ziolman/robothand1234/rysunki_obrazy_ilustracje/4_modul_pomiarowy_pola_magnetycznego.jpg

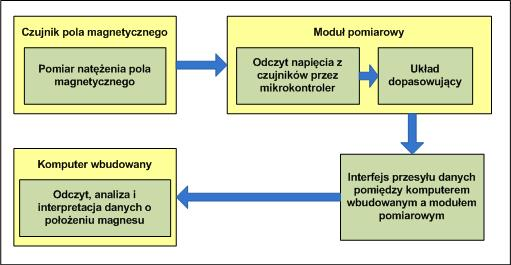
rysunki_obrazy_ilustracje/4_modul_pomiarowy_pola_magnetycznego.jpg
