ziolman/robothand1234/rysunki_obrazy_ilustracje/rys.jpg

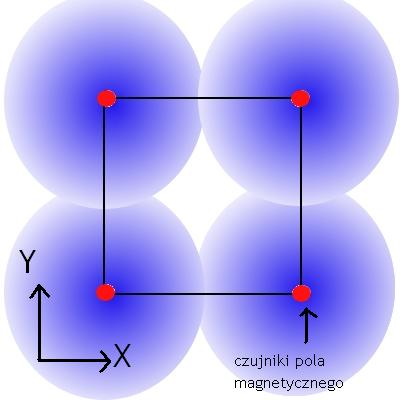
rysunki_obrazy_ilustracje/rys.jpg
