ziolman/robothand1234/projects/stepper_motor_translator_driver/stepper_motor_translator_driver (PCB - Schematic and PCB Check Report).txt

Schematic and PCB Check Report
------------------------------

Report File    : C:\Biblioteki\Robothand\robothand1234\projects\stepper_motor_translator_driver\stepper_motor_translator_driver (PCB - Schematic and PCB Check Report).txt
Report Written : Tuesday, December 25, 2012
Project Path   : C:\Biblioteki\Robothand\robothand1234\projects\stepper_motor_translator_driver\stepper_motor_translator_driver.prj
Design Path    : C:\Biblioteki\Robothand\robothand1234\projects\stepper_motor_translator_driver\stepper_motor_translator_driver.pcb
Design Title   : 
Created        : 2012-11-28 19:48:20
Last Saved     : 2012-12-17 07:27:35
Editing Time   : 3419 min
Units          : mm (precision 1)

Checking integrity of Schematic "C:\Biblioteki\Robothand\robothand1234\projects\stepper_motor_translator_driver\stepper_motor_translator_driver.sch" with PCB "C:\Biblioteki\Robothand\robothand1234\projects\stepper_motor_translator_driver\stepper_motor_translator_driver.pcb"
==================================================================================================================================================================================================================================================================================

Ignoring instance H1 ("MOUNT-HOLE3.0") as it has no schematic information.
Ignoring instance H2 ("MOUNT-HOLE3.0") as it has no schematic information.
Ignoring instance H3 ("MOUNT-HOLE3.0") as it has no schematic information.
Ignoring instance H4 ("MOUNT-HOLE3.0") as it has no schematic information.

Change value "R" on component reference "R7" to "10 Ohm".

Change value "R" on component reference "R8" to "10 Ohm".

End Of Report.
