ziolman/robothand1234/projects/uart_rs485/uart_rs485 (PCB - Pour Copper Report).txt

Pour Copper Report
------------------

Report File    : C:\Biblioteki\Robothand\robothand1234\projects\uart_rs485\uart_rs485 (PCB - Pour Copper Report).txt
Report Written : Sunday, December 23, 2012
Design Path    : C:\Biblioteki\Robothand\robothand1234\projects\uart_rs485\uart_rs485.pcb
Design Title   : 
Created        : 2012-12-22 23:36:58
Last Saved     : 2012-12-23 00:08:53
Editing Time   : 38 min
Units          : mil (precision 1)

End Of Report.
