ziolman/robothand1234/projects/differential_amplifiers_sensors_multi/differential_amplifiers_sensors (PCB - Pour Copper Report).txt

Pour Copper Report
------------------

Report File    : C:\Biblioteki\Robothand\robothand1234\projects\differential_amplifiers_sensors_multi\differential_amplifiers_sensors (PCB - Pour Copper Report).txt
Report Written : Tuesday, December 11, 2012
Project Path   : C:\Biblioteki\Robothand\robothand1234\projects\differential_amplifiers_sensors_multi\differential_amplifiers_sensors.prj
Design Path    : C:\Biblioteki\Robothand\robothand1234\projects\differential_amplifiers_sensors_multi\differential_amplifiers_sensors.pcb
Design Title   : 
Created        : 2012-12-11 06:53:57
Last Saved     : 2012-12-11 20:35:18
Editing Time   : 807 min
Units          : mil (precision 1)

End Of Report.
