ziolman/robothand1234/projects/fan controller/fan_controller (PCB - Pour Copper Report).txt

Pour Copper Report
------------------

Report File    : C:\Biblioteki\Robothand\robothand1234\projects\fan controller\fan_controller (PCB - Pour Copper Report).txt
Report Written : Friday, December 14, 2012
Design Path    : C:\Biblioteki\Robothand\robothand1234\projects\fan controller\fan_controller.pcb
Design Title   : 
Created        : 2012-12-14 09:00:22
Last Saved     : 2012-12-14 12:18:20
Editing Time   : 191 min
Units          : mil (precision 0)

End Of Report.
