ziolman/robothand1234/projects/magnetic_sensors_circuit/magnetic_sensors_circuit (PCB - Pour Copper Report).txt

Pour Copper Report
------------------

Report File    : C:\Biblioteki\Robothand\robothand1234\projects\magnetic_sensors_circuit\magnetic_sensors_circuit (PCB - Pour Copper Report).txt
Report Written : Friday, December 14, 2012
Project Path   : C:\Biblioteki\Robothand\robothand1234\projects\magnetic_sensors_circuit\magnetic_sensors_circuit.prj
Design Path    : C:\Biblioteki\Robothand\robothand1234\projects\magnetic_sensors_circuit\magnetic_sensors_circuit.pcb
Design Title   : 
Created        : 2012-12-14 14:24:42
Last Saved     : 2012-12-14 18:47:26
Editing Time   : 264 min
Units          : mil (precision 0)

End Of Report.
