ziolman/robothand1234/Praca magisterska BZ.docx

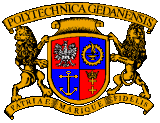
[picture p3: figure]
GODLO_C
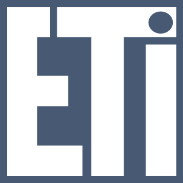
[picture p4: figure]
logo_eti

| Politechnika Gdańska WYDZIAŁ ELEKTRONIKI TELEKOMUNIKACJI I INFORMATYKI

Katedra: Metrologii i Optoelektroniki

Imię i nazwisko dyplomanta: Bartosz Ziółek

Nr albumu: 113592

Forma i poziom studiów: stacjonarne II stopnia

Kierunek studiów: elektronika i telekomunikacja

Praca dyplomowa

Temat pracy: Wbudowany system pomiarowy dedykowany dla ramienia ręki

Opiekun pracy: dr hab. inż. Wojciech Toczek

Zakres pracy:

1. Przegląd literatury na temat konstrukcji rąk robotów oraz systemów ich sterowania
2. Projekt ręki robota
3. Projekt systemu pomiarowego
4. Projekt systemu sterowania ręką robota
5. Wykonanie, uruchomienie oraz przetestowanie prototypu urządzenia

Gdańsk, 2012 rok

OŚWIADCZENIE

Oświadczam, że niniejszą pracę dyplomową wykonałem samodzielnie. Wszystkie informacje umieszczone w pracy uzyskane ze źródeł pisanych oraz informacje ustne pochodzące od innych osób zostały udokumentowane w wykazie literatury odpowiednimi odnośnikami.

podpis dyplomanta

Spis treści

# 1. Wstęp

Metody pomiarowe i diagnostyczne pełnią ważną funkcję w robotyce. Są szczególnie istotne w przypadku trudnych pomiarów, jak na przykład pomiary dokładności odtwarzania trajektorii w przestrzeni roboczej przy dużych prędkościach przemieszczania kiści robota.

W ramach pracy magisterskiej oraz rozwijania własnej pasji związanej z automatyką i robotyką zrealizowano wbudowany system pomiarowy dedykowany dla ręki robota humanoidalnego. Został przedstawiony zarys aktualnego stanu wiedzy na temat wielopalczastych manipulatorów zwanych, jako ręce robotów lub zręczne dłonie robotów, na tle dostępnych i opublikowanych rozwiązań konstrukcyjnych rąk robotów. Zaproponowano eksperymentalną konstrukcję oraz innowacyjny system i instalację sterowania humanoidalną kończyną górną robota. Podjęto próbę replikacji możliwości oraz złożoności ludzkiej ręki oraz jego kinematyczną oraz dynamiczną strukturę, gdzie najbardziej istotnym elementem jest system pomiarowy zastosowany w prototypie. Przeanalizowano niektóre ważne prace prowadzone na całym świecie w ostatnich trzech dekadach, dokonano przeglądu dostępnych aktuatorów, sensorów oraz technologii sterowania ramionami robotów antropomorficznych. Przedstawiono niespotykane wcześniej podejście w projektowaniu systemów pomiarowych dedykowanych dla ramion robotów, proponując eksperymentalne podejście sterowania manipulatorem.

W ramach pracy magisterskiej wykonano następujące zadania:

- dokonano przeglądu literatury dotyczącej konstrukcji robotów przemysłowych oraz humanoidalnych i systemów ich sterowania następnie sformułowano wymagania techniczne oraz technologiczne dla projektowanego urządzenia,
- zaprojektowano konstrukcję ramienia robota,
- wybrano komputer wbudowany,
- wybrano czujniki oraz układy dopasowujące,
- zaprojektowano schematy ideowe sterowników silników krokowych, układów dopasowujących oraz wzmacniających sygnały sensorów robota
- zaprojektowano oraz wykonano płytkę drukowaną prototypu sterownika silnika krokowego
- zaprojektowano i wykonano oprogramowanie komputera wbudowanego oraz mikroprocesorów
- wykonano prototyp ramienia robota humanoidalnego
- uruchomiono i przebadano działający prototyp
- poświęcono uwagę zagadnieniom sterowania z uwzględnieniem siły w układach ze sprzężeniem zwrotnym

Zaprojektowany system pomiarowy dedykowany jest dla manipulatora antropomorficznego.

# 2. Przegląd literatury oraz dostępnych rozwiązań konstrukcyjnych rąk robotów

## 2.1 Wybrane konstrukcje dłoni robotów humanoidalnych – struktury kinematyczne, systemy pomiarowe oraz napędowe

Dłoń ludzka jest jednym z najbardziej skomplikowanych, po mózgu, organem ludzkiego ciała. Jest przedmiotem studiów i badań nie tylko w medycynie, ale również w dziedzinie inżynierii.

### 2.1.1 Dłoń Utah/MIT

Dłoń Utah/MIT (ang. The Utah/MIT Hand) została opracowania przez Centrum Inżynierii Projektowej na Uniwersytecie w Utah oraz w Laboratorium Sztucznej Inteligencji w Instytucie Technologicznym w Massachusetts. Konstrukcja efektora końcowego robota miała funkcjonować jako narzędzie badawcze ogólnego przeznaczenia do badań sprawności podobnych rozwiązań konstrukcyjnych. Pierwotnie miała przypominać ludzką dłoń, ostatecznie przypominała quasi-antropomorficzną dłoń z trzema palcami oraz jednym kciukiem. Powodem, dla którego konstrukcja miała przypominać ludzką dłoń były, w pierwszej kolejności, badania systemu pomiarowego oraz czujników stosowanych wcześniej w podobnych konstrukcjach, po drugie, umożliwienie badaczom porównania oraz odwzorowywania operacji ręki ludzkiej za pomocną mechanicznej ręki robota. Strukturę mechaniczną danej konstrukcji przedstawia rysunek poniżej.

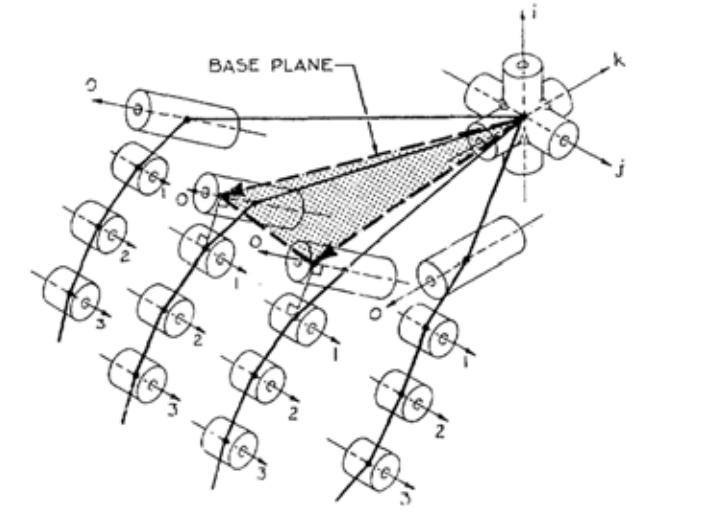
[picture p5: figure]

Rys. 2.1 Konfiguracja dłoni Utah/MIT (wersja trzecia projektu, połączenia 0 są równoległe do podstawy) [1]

Wykorzystano ścięgno-pasowy mechanizm przy każdym z siłowników z 16 stopni swobody. W tego typu mechanizmach jeden koniec ścięgna jest połączony z siłownikiem pneumatycznym, natomiast drugi jest zamocowany na zawiasie, który znajduje się na przemieszczanym segmencie palca. W celu zapewnienia prawidłowego działania, dwa pierwsze połączenia każdego palca oddzielono w taki sposób, że mogą ścięgna być kierowane prawidłowo, co ma istotne znaczenie w systemie pomiarowym dedykowanym dla danego rozwiązania.

Czujniki wewnętrzne dłoni umieszczone są na każdym połączniu w celu pomiaru odchylenia kątowego. System czujników oparty jest na efekcie Halla. Czujniki działające na danej zasadzie umieszczone są w bliższym ogniwie a dwa magnesy samarto-kobaltowe, działające w konfiguracji dipola, są dołączone do dalszego ogniwa. Pozostałe czujniki umieszczone są w każdym z 32 modułów wykrywania napięcia ścięgien zlokalizowanych w nadgarstku. Wykorzystywane zostały również czujniki tensometryczne do pomiarów siły działającej na każdą z belek podtrzymujących napinacze ścięgien, w postaci lin.

Do każdego z dwóch przegubów zamocowano dwa ścięgna, co spowodowało, iż liczba siłowników wymaganych do ich poruszania podwoiła liczbę złączy palców. W wersji trzeciej projektu dłoni Utah/MIT wykorzystano podwójne siłowniki składające się z dwóch ciśnieniowych zaworów sterujących, dwóch cylindrycznych siłowników pneumatycznych. Cylindry siłowników, tłoki siłowników oraz pozostałe mechanizmy napędowe ważyły łącznie 20 kg.

### 2.1.2 Konstrukcja robonauty

### 2.1.3 Dłoń belgradzka/USC

### 2.1.4 Dłoń cień

### 2.1.5 Czarne palce

# 3. Projekt manipulatora oraz systemu pomiarowego, głowne założenia projektowe

## 3.1 Założenia projektowe, podstawowe wymagania dotyczące ręki robota i dedykowanego systemu pomiarowego

# 4. Mechanika ręki robota a system pomiarowy i sterowania robota

## 4.1 Struktura manipulatora

## 4.2 Kinematyka manipulatora

## 4.3 Dynamika oraz statyka zaprojektowanego manipulatora

## 4.4 Konstrukcja chwytaka

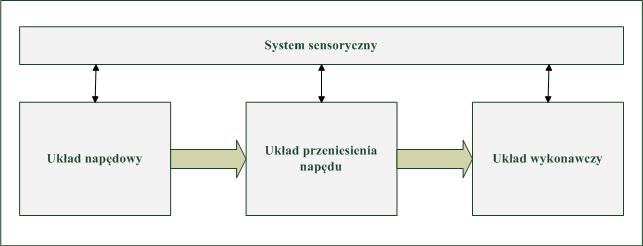
[picture p6: figure]

Rys. 4.1 Schemat blokowy chwytaka [2, p. 231]

# 5. Czujniki i układy sensoryczne robota dedykowane dla projektowanego wbudowanego systemu pomiarowego

Układy sensoryczne w robotyce są ważnymi elementami konstrukcji robotów. W celu prawidłowego funkcjonowania zaprojektowanej ręki robota wymagane było zaprojektowanie wielu układów pomiarowych służących do wprowadzania informacji o cechach mechanicznych, fizykochemicznych środowiska zewnętrznego, o orientacji oraz współrzędnych manipulatora i jego poszczególnych elementach składowych jak i stanie zewnętrznym środowiska otaczającego robota. Uzyskiwane dane wykorzystywane są do sterowania manipulatorem z zastosowaniem sprzężeń zwrotnych, sprzężonych z komputerem wbudowanym robota.

Stworzono klasyfikację układów sensorycznych na potrzeby danej pracy na podstawie [3, p. 198] oraz [2, pp. 261-291], co zobrazowano na rysunku Rys. 5.1. Kolorem zielonym zaznaczono rodzaje czujników wykorzystywanych w projekcie.

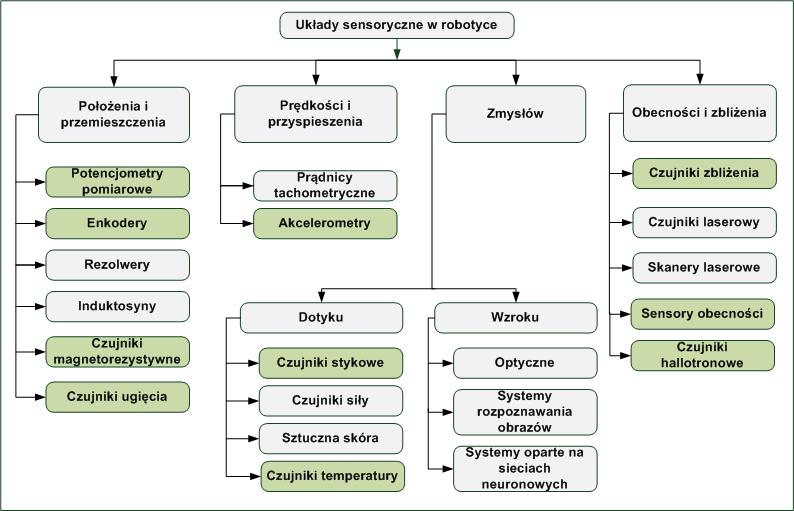
[picture p7: figure]

Rys. 5.1 Klasyfikacja układów sensorycznych analizowanych oraz stosowanych w danym projekcie

## 5.1 Układy pomiarowe położenia i przemieszczenia

### 5.1.1 Moduł sensoryczny położenia i przemieszczenia z czujnikami magnetorezystywnymi – badanie czujników, prototyp modułu pomiarowego

Do pomiaru położenia końców poszczególnych segmentów robota w przestrzeni wykorzystano czujniki magnetorezystywne pola magnetycznego. Stworzono eksperymentalny moduł pomiarowy celem sprawdzenia dokładności pomiarów oraz ich przydatności w określaniu położenia w przestrzeni trójwymiarowej manipulatora w danym projekcie.


Rys. 5.2 Schemat blokowy modułu pomiarowego pola magnetycznego

Na rysunku Rys. 5.2 przedstawiony został schemat blokowy zbudowanego prototypu modułu pomiarowego pola magnetycznego. Moduł czujników pola magnetycznego złożony jest z odpowiednio rozmieszczonych czujników natężenia pola magnetycznego (wykorzystywano czujniki KMZ10C oraz SS49), przewodów doprowadzających sygnały z czujników do modułu pomiarowego (w celu zwiększenia niezawodności pomiarów oraz dokładności podjęto próbę ekranowanie danych przewodów, jednak nie stwierdzono żadnej poprawy niezawodności). Głównym elementem widocznego na schemacie modułu pomiarowego jest mikrokontroler ATMEGA32. Moduł składa się również z układów dopasowujących oraz wzmacniających sygnały z czujników. W celu przesyłu danych do komputera wykorzystywany jest interfejs RS-232. Aplikacja napisana w języku C uruchamiana jest na komputerze wbudowanym wyposażonym w złącze RS-232 lub jeśli jest do dyspozycji konwerter RS-232 – USB – w port USB. Wykorzystując dany program odczytywane są pomiary ze wszystkich sensorów na podstawie których następuje interpretacja położenia magnesu w przestrzeni dwuwymiarowej bądź trójwymiarowej, w zależności od zastosowanego modelu matematycznego. Aplikacja umożliwia także kalibrację układu czujników, uzyskiwanych pomiarów. Dzięki funkcji auto-kalibracji urządzenie nie wymaga przeznaczania sporych wysiłków na poprawne skalibrowanie – oszczędność czasu.

Powodzenie próby dokonania poprawnych i dokładnych pomiarów zależało przede wszystkim od doboru odpowiednich czujników natężenia pola magnetycznego. Znaczną część czasu przeznaczoną na projektowanie urządzenia przeznaczono na rozeznanie i wybór właściwych czujników magnetorezystywnych: KMZ10C. Są to dość tanie elementy, których wykorzystanie pozwala na zbudowanie magnetycznego miernika położenia. Zastosowanie dokładniejszych, droższych czujników (np. KMZ51) pozwoliłoby na uzyskanie większej dokładności oraz pozwoliłoby na zmniejszenie liczby czujników wymaganych do poprawnego określania położenia obiektu w przestrzeni. Nie otrzymano oczekiwanych rezultatów przy wykorzystaniu danego modułu, jednak ze względu na podjętą próbę zastosowania czujników magnetorezystywnych w konstrukcji ręki robota (o danej metodzie pomiarowej stosowanej przy robotach humanoidalnych projektant nie znalazł żadnych informacji w dostępnej literaturze oraz Internecie) opisano w danej pracy przeprowadzone eksperymenty oraz wyciągnięto odpowiednie wnioski.

Zastosowany w module eksperymentalnym sensor to czujnik pola magnetycznego o dużej czułości wykorzystujący zjawisko megnetorezystancji. Stosowany jest do pomiaru natężenia pola magnetycznego. Jego działanie opiera się na zmianie rezystancji elektrycznej materiałów, z których został wykonany, poddanych działaniu pola magnetycznego. Struktura wewnętrzna czujnika zawiera pełny mostek magnetorezystywny. Czujniki tego rodzaju charakteryzują się dużą czułością. Schemat czujnika KMZ10C, jego struktura wewnętrzna oraz rozkład wyprowadzeń został przedstawiony poniżej na rysunku Rys. 5.3 oraz Rys. 5.4.Ze względu na specyfikę oraz konstrukcję płytki PCB modułu pomiarowego, możliwość ustawiania własnej konfiguracji urządzenia, konieczna jest znajomość wyprowadzeń czujnika, jego orientacji w przestrzeni względem położenia magnesu.

Rys. 5.3 Schemat czujnika KMZ10 – rozkład wyprowadzeń – struktura czujnika [4]

Rys. 5.4 Schemat czujnika KMZ10C – rozkład wyprowadzeń [4]

Rys. 5.5 Charakterystyka wyjściowa czujnika KMZ10 (Hy-natężenie pola magnetycznego, V0-napięcie wyjściowe czujnika) [4]

Zobrazowane spektrum, zakres wykrywania pola magnetycznego przez dany czujnik, wykorzystywane w projekcie, ukazano na Rys. 5.6, natomiast na rysunku Rys. 5.5 przedstawiono charakterystykę wyjściową czujnika KMZ10C. W idealnych warunkach czujnik charakteryzuje się liniową charakterystyką wyjściową – co jest dużą zaleta. Wykorzystując dany sensor można dokonać pomiaru w dwóch płaszczyznach Hx oraz Hy W projekcie wykorzystano pomiar pola magnetycznego w płaszczyźnie y (zgodnie z zamieszczonym powyżej rysunkiem), gdyż czujnik w takim położeniu, w odniesieniu do mierzonego pola magnetycznego, charakteryzuje się największą czułością oraz zakresem pomiarowym. Zakres pomiarowy, zgodnie z dokumentacją czujnika (sprawdzono doświadczalnie): -7,5 kA/m .. +7,5 kA/m, natomiast czułość to: 1,5 (mV/V)/(kA/m). Maksymalne napięcie zasilania czujnika wynosi 10 V.

Poprzez zastosowanie odpowiedniego układu wzmacniacza, możliwe stało się wykrywanie/mierzenie natężenia pola magnetycznego w odległości ok. 30-25 cm od źródła danego pola. Zaprojektowany układ (schemat) wzmacniacza dedykowany dla danego czujnika przedstawiono na Rys. 5.7. Poprzez zastosowanie rezystorów o większej wartości rezystancji możliwe jest zwiększenie wzmocnienia danego układu.

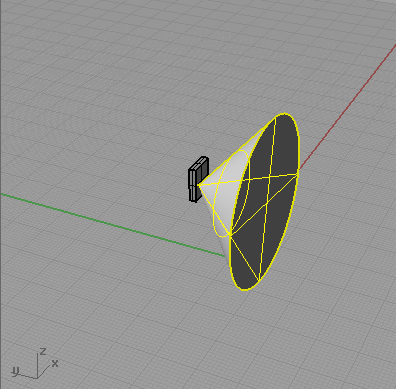
[picture p8: figure]

Rys. 5.6 Spektrum, zakres wykrywania pola magnetycznego przez czujnik KMZ10C - wizualizacja dokonana przez projektanta w programie Blender

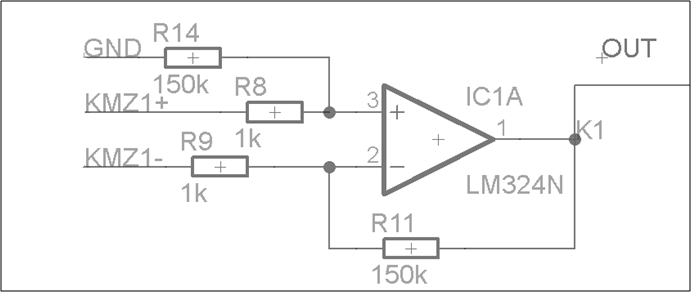
[picture p9: figure]

Rys. 5.7 Układ wzmacniacza sygnału z czujnika KMZ10C

Właściwości czujników KMZ10C umożliwiają stosowanie ich w pomiarach prądu i pola magnetycznego, czujnikach zbliżeniowych, układach pomiaru położenia.

Wyjścia sygnałowe czujników zbadano za pomocą oscyloskopu oraz multimetru, podczas przemieszczania magnesu względem czujnika na wykreślonej wcześniej, odpowiednio wyskalowanej tarczy (Rys. 5.8). Przy pomiarach nie można było wykluczyć działania pola magnetycznego Ziemi (zauważalne były zmiana sygnału wyjściowego przy przemieszczaniu czujnika KMZ10C względem powierzchni ziemi – przy odpowiednio dużym wzmocnieniu sygnału wyjściowego). Z wykorzystaniem czujnika KMZ10C wykrywano zmiany natężenia pola magnetycznego (po wzmocnieniu sygnału) ze znacznie większej odległości w porównaniu z wykorzystaniem innych dostępnych dla projektanta czujnikami hallotronowymi.

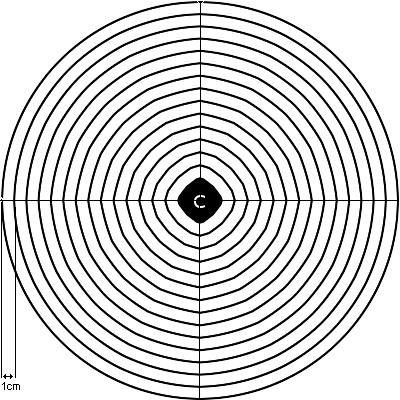
[picture p10: figure]

Rys. 5.8 Schemat szablonu pomiarowego dla czujników pola magnetycznego (C - miejsce położenia czujnika)

Ważne było, jaki magnes został wykorzystywany do przeprowadzania testów wybranych czujników. Używając różnych magnesów (materiał z jakich zostały wykonane), o różnych wymiarach oraz różnym stopniu namagnesowania otrzymano inne wyniki przy pomiarze napięć wyjściowych (sygnałów wyjściowych) z czujników. W danym projekcie modułu wykorzystywano magnes ferrytowy.

Przebadano zmiany napięcia wyjściowego wybranego czujnika magnetorezystywnego w funkcji odległości magnesu od czujnika. Wyniki przedstawiono w tabeli 5.1.

Tabela 5.1 Wyniki pomiarów zmian sygnału wyjściowego czujnika KMZ10C przy zmianie odległości położenia magnesu ferrytowego od czujnika

odległość magnesu od czujnika [cm] | wartość napięcia – wyjście czujnika [mV] (sygnał wzmocniony)
16 | 26
15 | 28
14 | 30
13 | 32
12 | 35
11 | 40
10 | 46
9 | 56
8 | 69
7 | 89
6 | 123
5 | 174
4 | 272
3 | 475
2 | 698

Na podstawie tych danych wyznaczono charakterystykę wyjściową czujnika KMZ10C w funkcji odległości od danego magnesu w kształcie prostopadłościanu (Rys. 5.9 Charakterystyka wyjściowa dla czujnika KMZ10C w funkcji odległości od magnesu ferrytowego w kształcie prostopadłościanu).

Rys. 5.9 Charakterystyka wyjściowa dla czujnika KMZ10C w funkcji odległości od magnesu ferrytowego w kształcie prostopadłościanu

Na podstawie wykresu zamieszczonego powyżej widać, iż rozkład pola magnetycznego w przestrzeni nie jest liniowy. Natężenie pola magnetycznego wzrasta znacznie, jeśli magnes jest zbliżany do czujnika. Bazując na tych danych wyznaczono (z wykorzystaniem programu Aproksymacja) zależność napięcia wyjściowego czujnika od odległości położenia magnesu od sensora:

| V_(out) =2600,1r^(-1,708) | 5.1

ogólnie:

| Vout = γr⁻¹,⁷ | 5.2

Widoczne jest podobieństwo danej zależności do [5]:

F_m =m_m H=m_m^2 /4πμ_0 r^2

gdzie:

Fm – siła magnetyczna

mm – „masa magnetyczna”

H – natężenie pola magnetycznego

μ0 – przenikalność magnetyczna próżni

r – odległość od źródła pola magnetycznego

W danym przypadku:

γ = m_m^2 /4πμ_0

jest stałą, zależną od rodzaju magnesu (materiał, wymiary, kształt), wyznaczaną doświadczalnie. Poprawne działanie aplikacji interpretującej położenie magnesu w przestrzeni było uzależnione od poprawnego wyznaczenia tej zależności dla wybranego magnesu, który był wykorzystywany. Rozbieżność w wykładnikach potęg zmiennej r we wzorach (4.1) oraz (4.3) wynika m.in. z nieliniowości, zniekształceń wnoszonych przez układy wzmacniaczy.

W projekcie modułu głównym przeznaczeniem mikrokontrolera jest odpowiednie próbkowanie kanałów z wyjść czujników analogowych (po odpowiednim wcześniejszym wzmocnieniu), przekształcenie ich na sygnał cyfrowy (przetworniki A/C), a następnie przesłanie do komputera wbudowanego za pomocą interfejsu RS-232. Do tego celu napisano odpowiednie oprogramowanie. Kod źródłowy został opisany w dalszej części danej pracy.

## 5.2 Układy sensoryczne zbliżenia i obecności

### 5.2.1 Układ pomiarowy z czujnikami hallotronowymi

W projekcie ręki robota wykorzystano czujniki hallotronowe, które pełnią rolę czujników zarówno obecności jak i zbliżenia. Czujniki hallotronowe dzieli się na przełączniki oraz czujniki liniowe [4, pp. 63-68]. Wykorzystano przełączniki, które posiadają wbudowany komparator ze zdefiniowanymi odpowiednio punktami przełączania oraz cyfrowym wyjściem, które zostało podłączone do systemu logicznego. W zależności od wartości i kierunku pola magnetycznego, wywołującego zadziałanie układu pomiarowego czujnika, przełączniki Halla są dzielone na kilka typów:

- blokujące (ang. latching sensors)
- jednobiegunowe (ang. unipolar sensors)
- dwubiegunowe (ang. bipolar sensors)

Wykorzystano dwa ostatnie typy czujników. Przełączniki jednobiegunowe nie wymagają zmian kierunku pola magnetycznego – polaryzacji, lecz jedynie jego wartości. Na ogół tego typu czujniki wymagają pola magnetycznego o polaryzacji dodatniej, skierowanej w stronę oznakowanej krawędzi czujnika. Taki czujnik nie reaguje na zmiany pola magnetycznego o polaryzacji odwrotnej (ujemnej).

Przełączniki dwubiegunowe są zbliżone w działaniu do przełączników blokujących. Charakterystyczne dla tych czujników jest, że sygnał wyjściowy z przetwornika nie zmienia się, jeżeli wartość natężenia pola magnetycznego dąży do zera (nie zawsze jednak w przypadku tych czujników jest spełniona zasada stałości sygnału wyjściowego, gdy pole magnetyczne). W celu zmiany stanu wyjścia należy przyłożyć do płytki Halla (zawartej w obudowie czujnika) pole magnetyczne o polaryzacji odwrotnej do działającej uprzednio. Jako czujnik unipolarny wybrano CS3144E. Są to czujniki, które posiadają wbudowany komparator ze zdefiniowanymi odpowiednio punktami przełączania oraz cyfrowym wyjściem, które zostało podłączone do systemu logicznego. Schemat funkcjonalny czujnika CS3144E pokazany jest na Rys. 5.2.

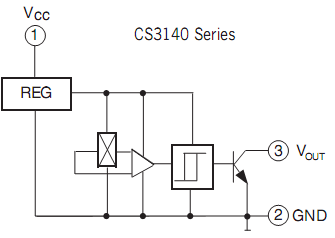
[picture p11: figure]

Rys. 5.10 Blok funkcjonalny czujnika hallotronowego serii CS3140 [5]

Maksymalne napięcie wejściowe i wyjściowe czujnika to 28 V, co odpowiada założeniom postawionym przez projektanta, opisanych w Rozdziale 3.1. Rozkład wyprowadzeń, charakterystyki zawarte są w dokumentacji czujnika w Załączniku X. Drugim czujnikiem jest czujnik bipolarny Halla AH175. Zakres napięć pracy czujnika to 3,5 V – 20 V, zarówno na wejściu jak i wyjściu układu półprzewodnikowego. Na Rys. 5.3 przedstawiono blok funkcjonalny wraz z wyprowadzeniami czujnika

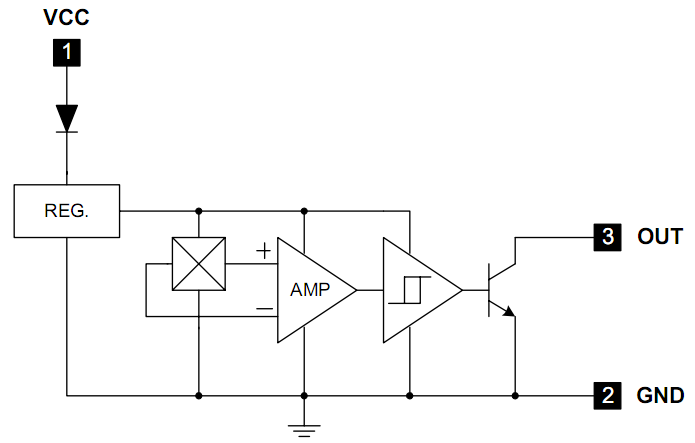
[picture p12: figure]

Rys. 5.11 Diagram blokowy czujnika AH175 [6]

W projekcie przewidziano również możliwość podłączenia liniowych czujników Halla. Generują one sygnał analogowy napięciowy proporcjonalny do indukcji magnetycznej działającej na płytkę Halla. Ten typ czujników stosowany jest m.in. do pomiaru kąta rozwarcia pomiędzy ramieniem a przedramieniem, położenia poszczególnych przegubów, stawów względem obudowy robota, kąta obrotu przegubu, może zostać również zastosowany do pomiaru natężeń prądów. Przykładem czujnika tego typu jest czujnik CS3503.

Każdy z czujników hallotronowych jest wzmacniany. Dokonywane jest to za pośrednictwem wzmacniacza różnicowego na bazie układu TL074. Napięcie wyjściowe poddawane jest regulacji z zakresu 2 V – 22 V. Schemat ideowy opisywanego układu jest przedstawiony na Rys. 5.4.

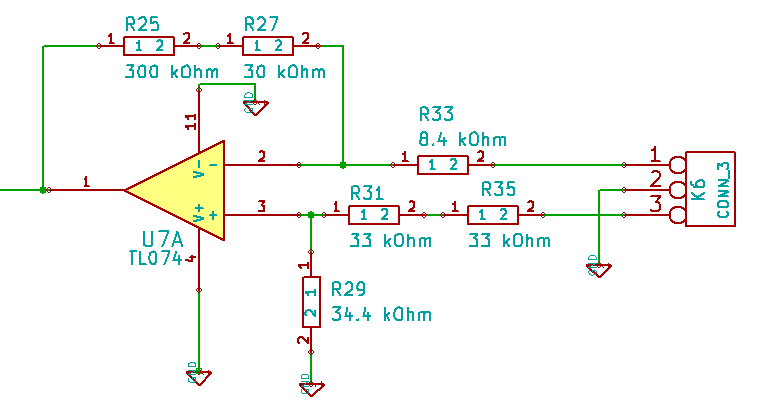
[picture p13: figure]

Rys. 5.12 Schemat ideowy układu wzmacniacza sygnału z czujnika Halla bipolarnego oraz unipolarnego

### 5.2.2 Wzmacniacz czujnika optycznego

Przewidziano możliwość dołączenia czujników fotoelektrycznych (optycznych). Są to diody kierunkowe oraz diody na podczerwień. Spełniają rolę markerów w celu określenia początkowych punktów pracy robota. Element nadawczy (w przypadku toru na podczerwień) stanowi dioda nadawcza CQYP16, fotodetektorem jest dioda odbiorcza BPW84. W układzie elektronicznego przełącznika świetlnego wykorzystano fototranzystor BPY22.

Układ wzmacniacza czujnika optycznego składa się ze wzmacniacza OP07CR, który pracuje w konfiguracji komparatora. Porównywany jest poziom napięcia pomiędzy wejściem odwracającym a nieodwracającym. Na wyjściu uzyskuje się wysoki albo niski sygnał, w zależności od napięcia zasilającego VCOM wzmacniacza. Napięcie na wejściu nieodwracającym jest ustalane przy pomocy potencjometru RV4 (Rys. 5.5). Kiedy fotodioda podłączona pod wejścia K13 (anoda – 2, katoda – 3) nie jest oświetlona, prąd płynący przez dany element elektroniczny nie płynie. Powoduje to wzrost napięcia na pinie 2 wzmacniacza, na wyjściu otrzymuje się niski poziom napięcia. Sytuacja jest odwrotna w momencie, w którym fotodioda zostaje oświetlona.

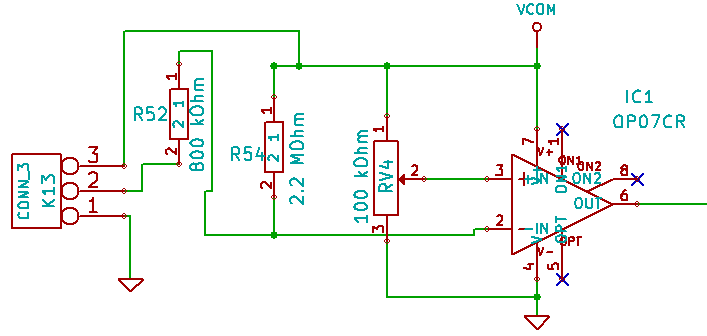
[picture p14: figure]

Rys. 5.13 Schemat ideowy układu przetwarzania sygnału czujnika optycznego

Rolę fotodiody może pełnić fotodioda kierunkowa, albo zastosowana przez konstruktora dioda IR BPW84. Jako diodę nadawczą zastosowano CQYP16 działającą również w zakresie podczerwieni. Podłączana jest również do złącza K13 do wejścia 1 oraz 3 (należy zwracać uwagę na prawidłowe połączenie elementu, polaryzację). Rezystor R52 pełni funkcję zabezpieczającą diody. W urządzeniu znajduje się dziesięć takich podukładów, istnieje możliwość podłączenia dziesięciu czujników optycznych (działających na takich samych zasadach, co przedstawione powyżej), w zależności od zaistniałych potrzeb.

# 6. Sterowanie oraz planowanie zadań robota

# 7. Podsumowanie, uwagi i wnioski końcowe

Wadą zaprojektowanej konstrukcji ramienia robota jest zastosowanie nieodpowiednich materiałów. Konstrukcja jest za ciężka - rozwój inżynierii materiałowej umożliwia obecnie stosowanie lekkich kompozytów do budowy robotów. Ma to również swoje zalety, ponieważ wykorzystywanie materiałów kompozytowych w budowie robotów prowadzi do zwiększenia prędkości, ale równolegle wywołuje efekt dynamicznej podatności, które należy uwzględnić w procesie sterowania. Ze względu na ograniczony czas przeznaczony na budowę ramienia nie stosowano podczas wykonania prototypu w stopniu odpowiednim metod symulacji komputerowych w zakresie projektowania robotów.

## 7.1 Dalsza wizja rozwoju projektu

W celu ukończenia projektu należy w dalszych etapach prac nad ręką robota:

- poprawić algorytm modelowania przestrzeni w aplikacji systemu wbudowanego opartego na komputerze typu embedded Beagle Board
- zaprojektować i wykonać poprawioną płytkę PCB układu sensorycznego położenia i przemieszczenia czujników magnetorezystywnych

# Bibliografia

[1] | S. C. Jacobsen, E. K. Iversen, D. F. Knutti, R. T. Johnson i K. B. Biggers, „Design of the Utah/M.I.T. Dextrous Hand,” w Proc. IEEE International Conference on Robotics and Automation, 1986.
[2] | Praca zbiorowa pod redakcją A. Moreckiego i J. Knapczyka, Podstawy robotyki - Teoria i elementy manipulatorów oraz robotów, III red., Warszawa: WNT, 1999.
[3] | J. Honczarenko, Roboty przemysłowe, Warszawa: WNT, 2004.
[4] | A. Gajek i Z. Juda, Czujniki, Mechatronika samochodowa, Warszawa: WKiŁ, 2008.
[5] | „Czujnik hallotronowy CS3144,” [Online]. Available: http://www.testequipmentdatasheets.com/index_cards/F/FW_Bell/CS3140.pdf. [Data uzyskania dostępu: 01 09 2012].
[6] | „Czujnik hallotronowy AH175,” [Online]. Available: http://www.chipcatalog.com/Anachip/AH175.htm.
[7] | J. W. Soto Martell i G. Gini, „Robotic Hands: Design Review and Proposal of New Design Process,” w World Academy of Science, Engineering and Technology 26, 2007.
