ziolman/robothand1234/projects/A3977_stepper_driver_second/A3977_stepper_driver.bmp

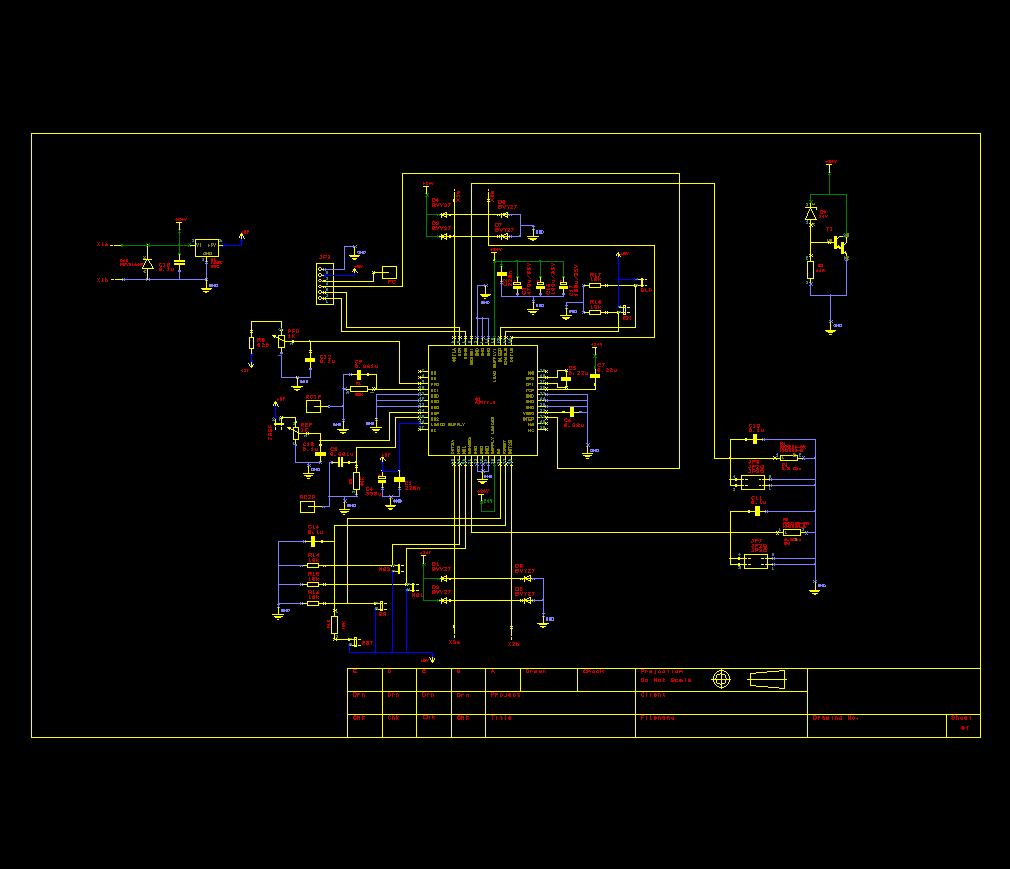
projects/A3977_stepper_driver_second/A3977_stepper_driver.bmp
