ziolman/robothand1234/rysunki_obrazy_ilustracje/5_schemat_blokowy_robota_reka.png

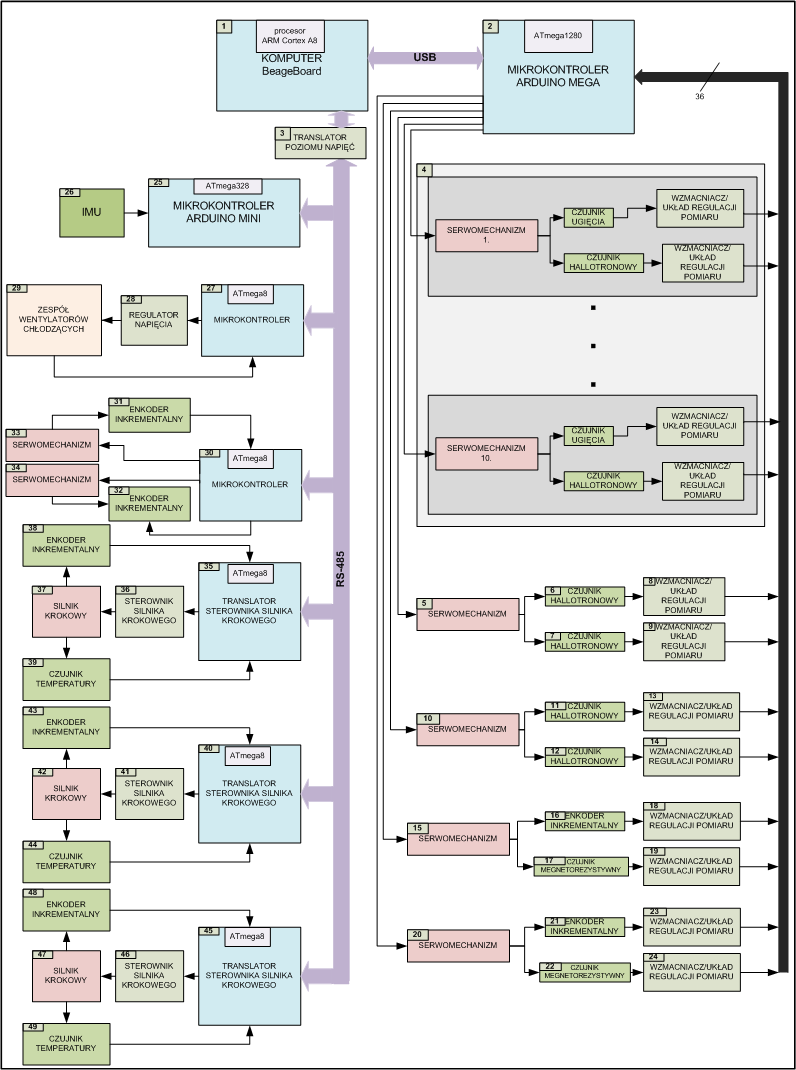
rysunki_obrazy_ilustracje/5_schemat_blokowy_robota_reka.png
