ziolman/robothand1234/rysunki_obrazy_ilustracje/9_interfejs_komunikacyjny_u_pomiarowy.png

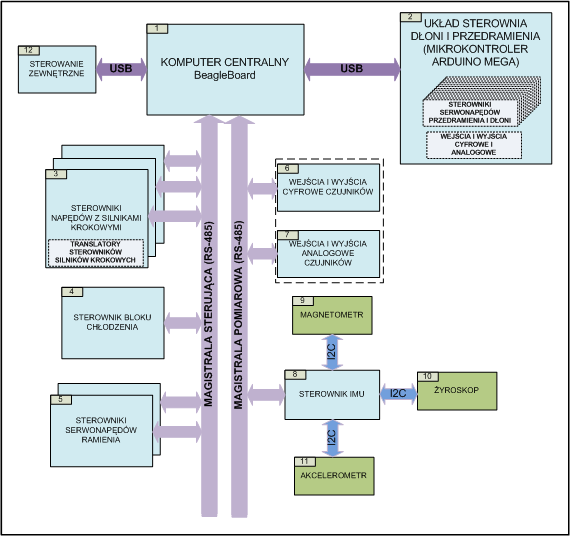
rysunki_obrazy_ilustracje/9_interfejs_komunikacyjny_u_pomiarowy.png
