ziolman/robothand1234/rysunki_obrazy_ilustracje/10_architektura_ukladu_mechatronicznego.png

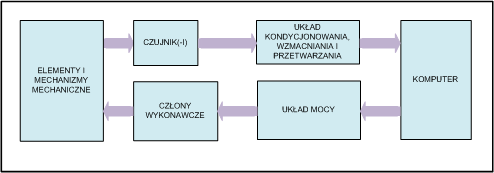
rysunki_obrazy_ilustracje/10_architektura_ukladu_mechatronicznego.png
