ziolman/robothand1234/rysunki_obrazy_ilustracje/11_postepowanie_mechatroniczne.png

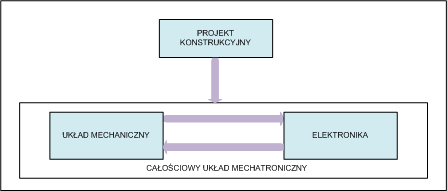
rysunki_obrazy_ilustracje/11_postepowanie_mechatroniczne.png
