ziolman/robothand1234/rysunki_obrazy_ilustracje/12_uklad_sterowania_z_kompensacyjna_siecia_neuronowa.png

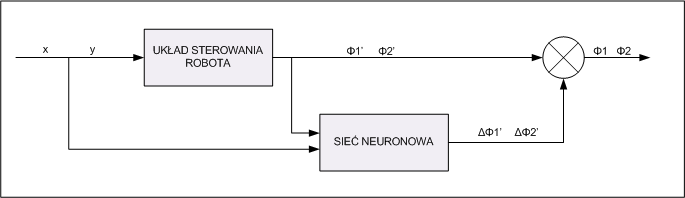
rysunki_obrazy_ilustracje/12_uklad_sterowania_z_kompensacyjna_siecia_neuronowa.png
