ziolman/robothand1234/rysunki_obrazy_ilustracje/13_napedy_robotow.png

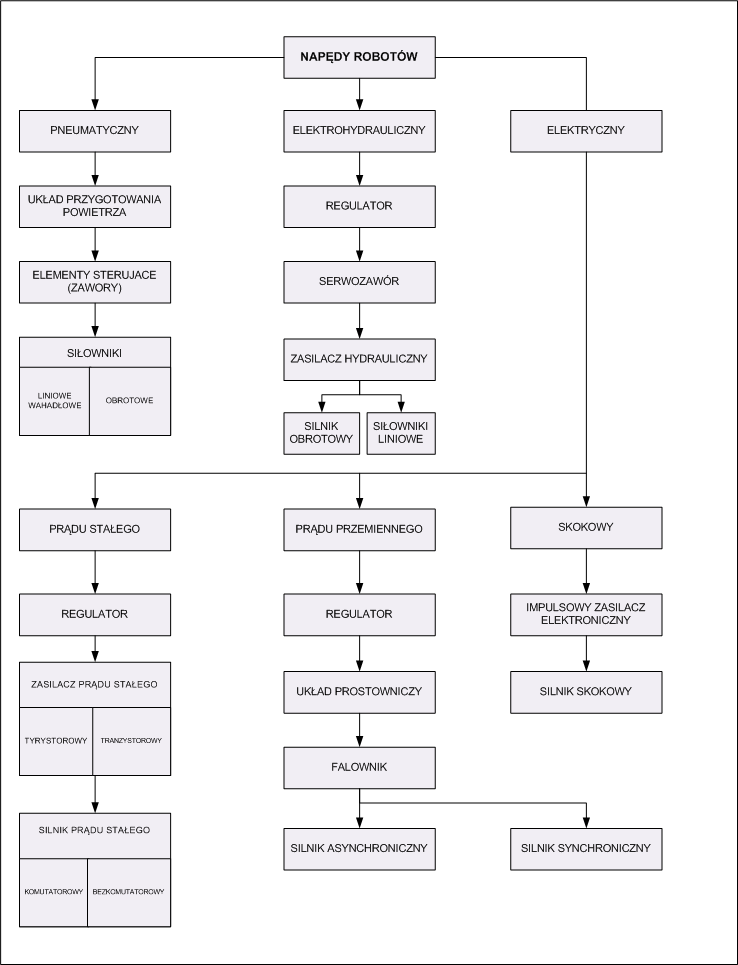
rysunki_obrazy_ilustracje/13_napedy_robotow.png
