ziolman/robothand1234/rysunki_obrazy_ilustracje/pomiar_za_pomoca_potencjometru_obrotowego.jpg

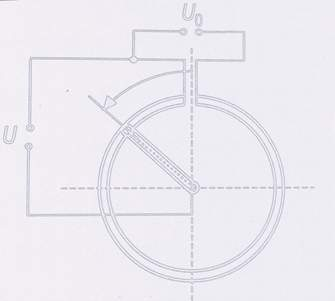
rysunki_obrazy_ilustracje/pomiar_za_pomoca_potencjometru_obrotowego.jpg
