ziolman/robothand1234/projects/fan controller/PCB Design_ fan_controller_bottom.pdf

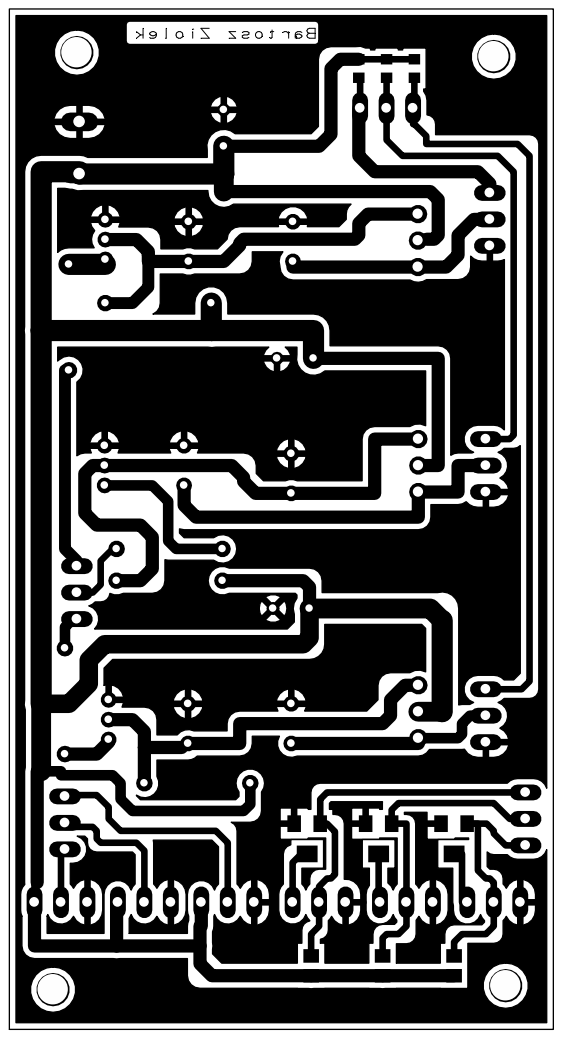
[picture p104: page 1]
