ziolman/robothand1234/projects/fan controller/Schematic Design_ Design1_single.pdf

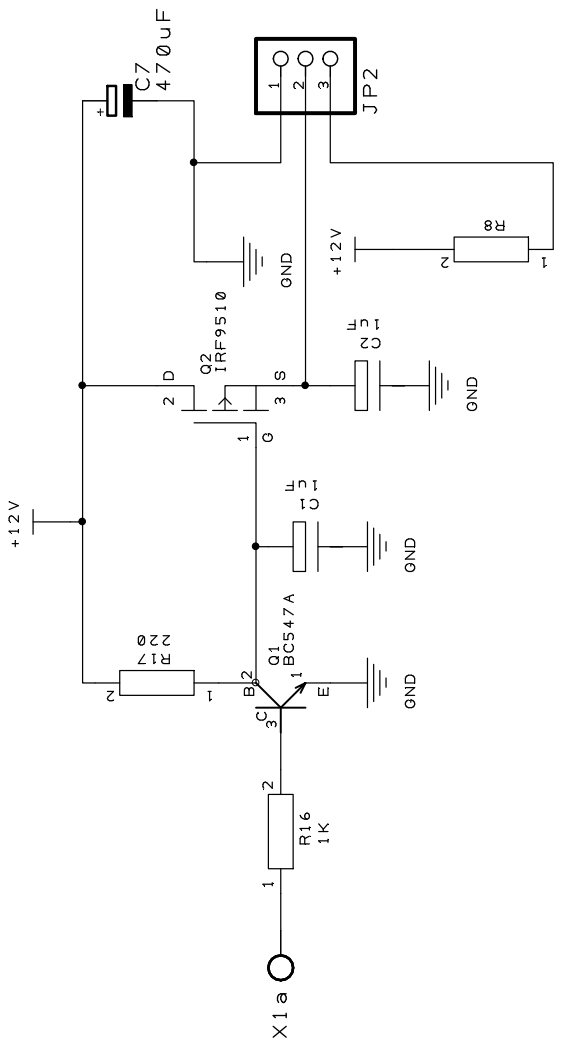
[picture p105: page 1]
