ziolman/robothand1234/projects/A3977_stepper_driver_second/PCB Design_ A3977_stepper_driver_bottom.pdf

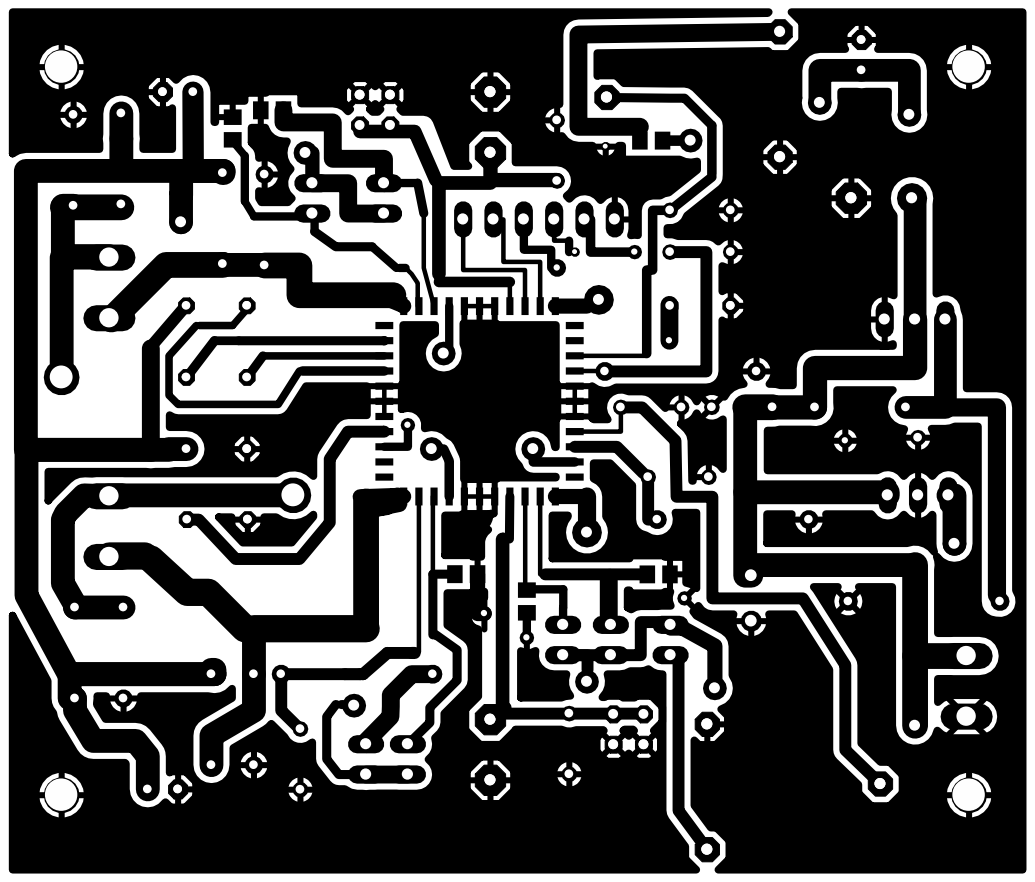
[picture p106: page 1]
