ziolman/robothand1234/projects/A3977_stepper_driver_second/PCB Design_ A3977_stepper_driver_description.pdf

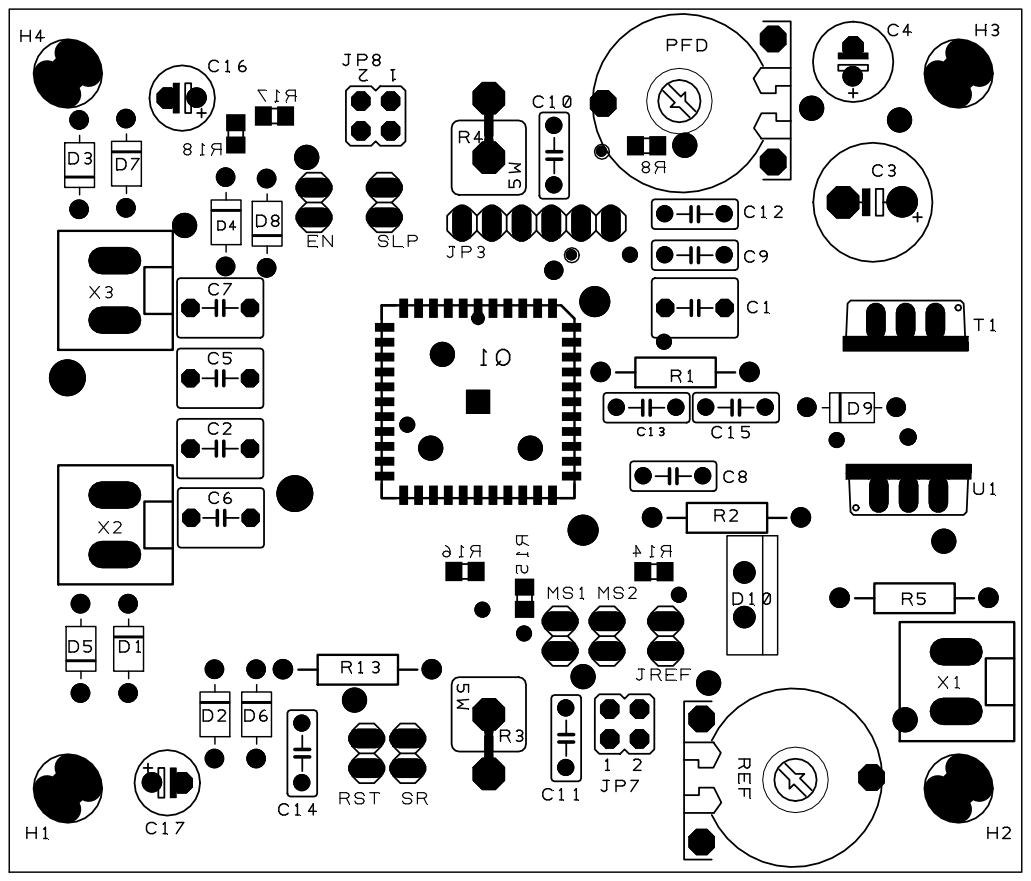
[picture p107: page 1]
