ziolman/robothand1234/projects/A3977_stepper_driver_second/PCB Design_ A3977_stepper_driver_top.pdf

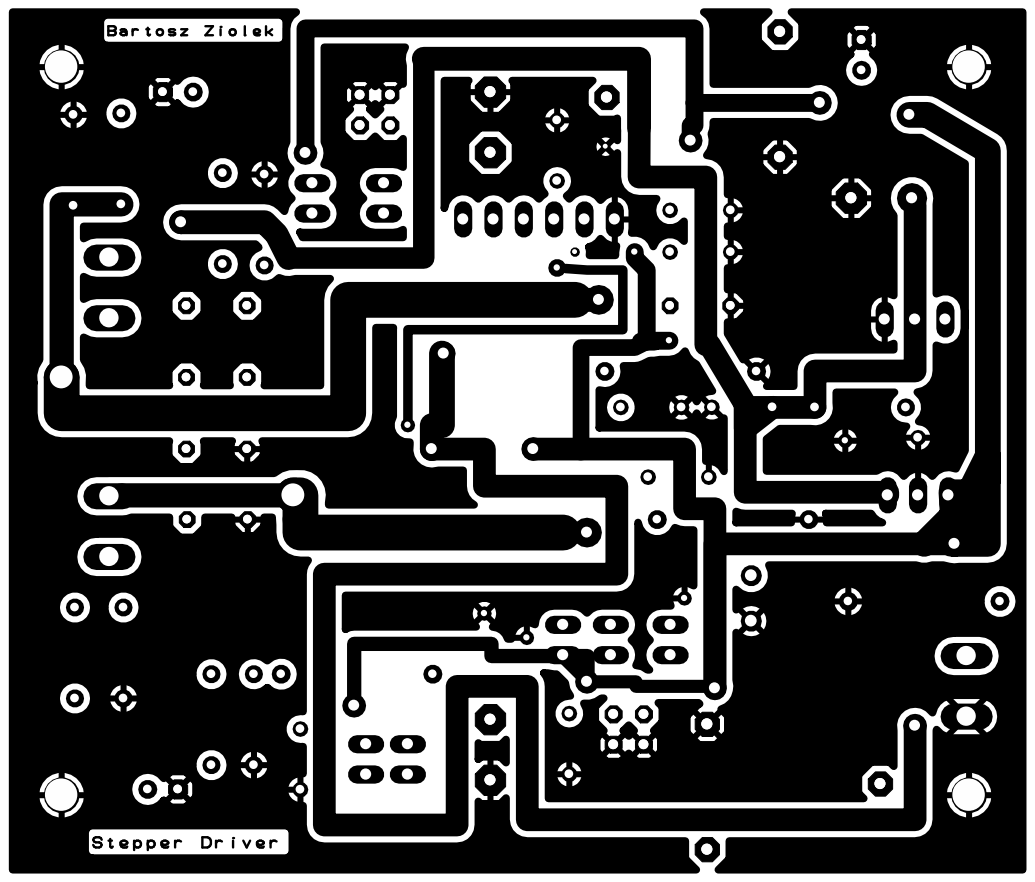
[picture p108: page 1]
