ziolman/robothand1234/projects/A3977_stepper_driver_second/Schematic Design_ A3977_stepper_driver.pdf

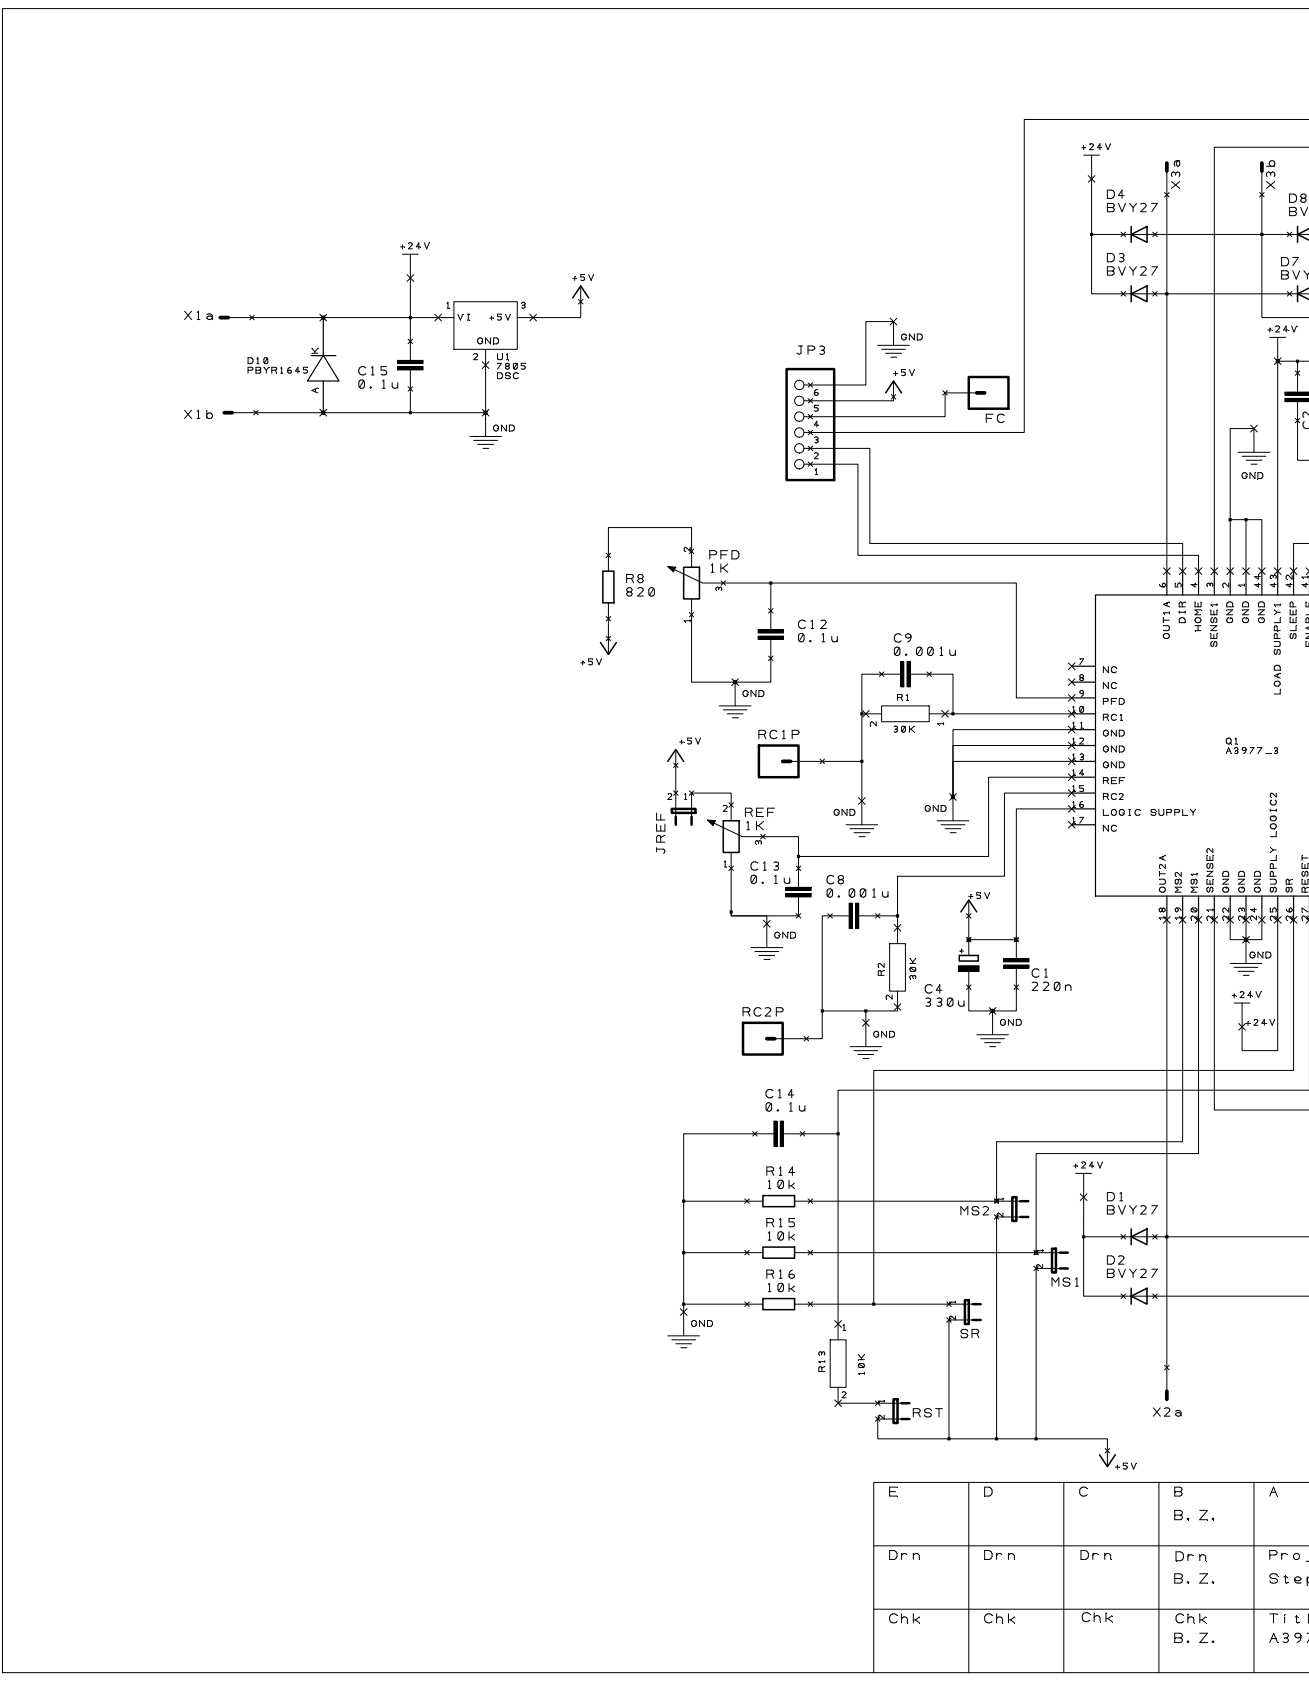
[picture p109: page 1]

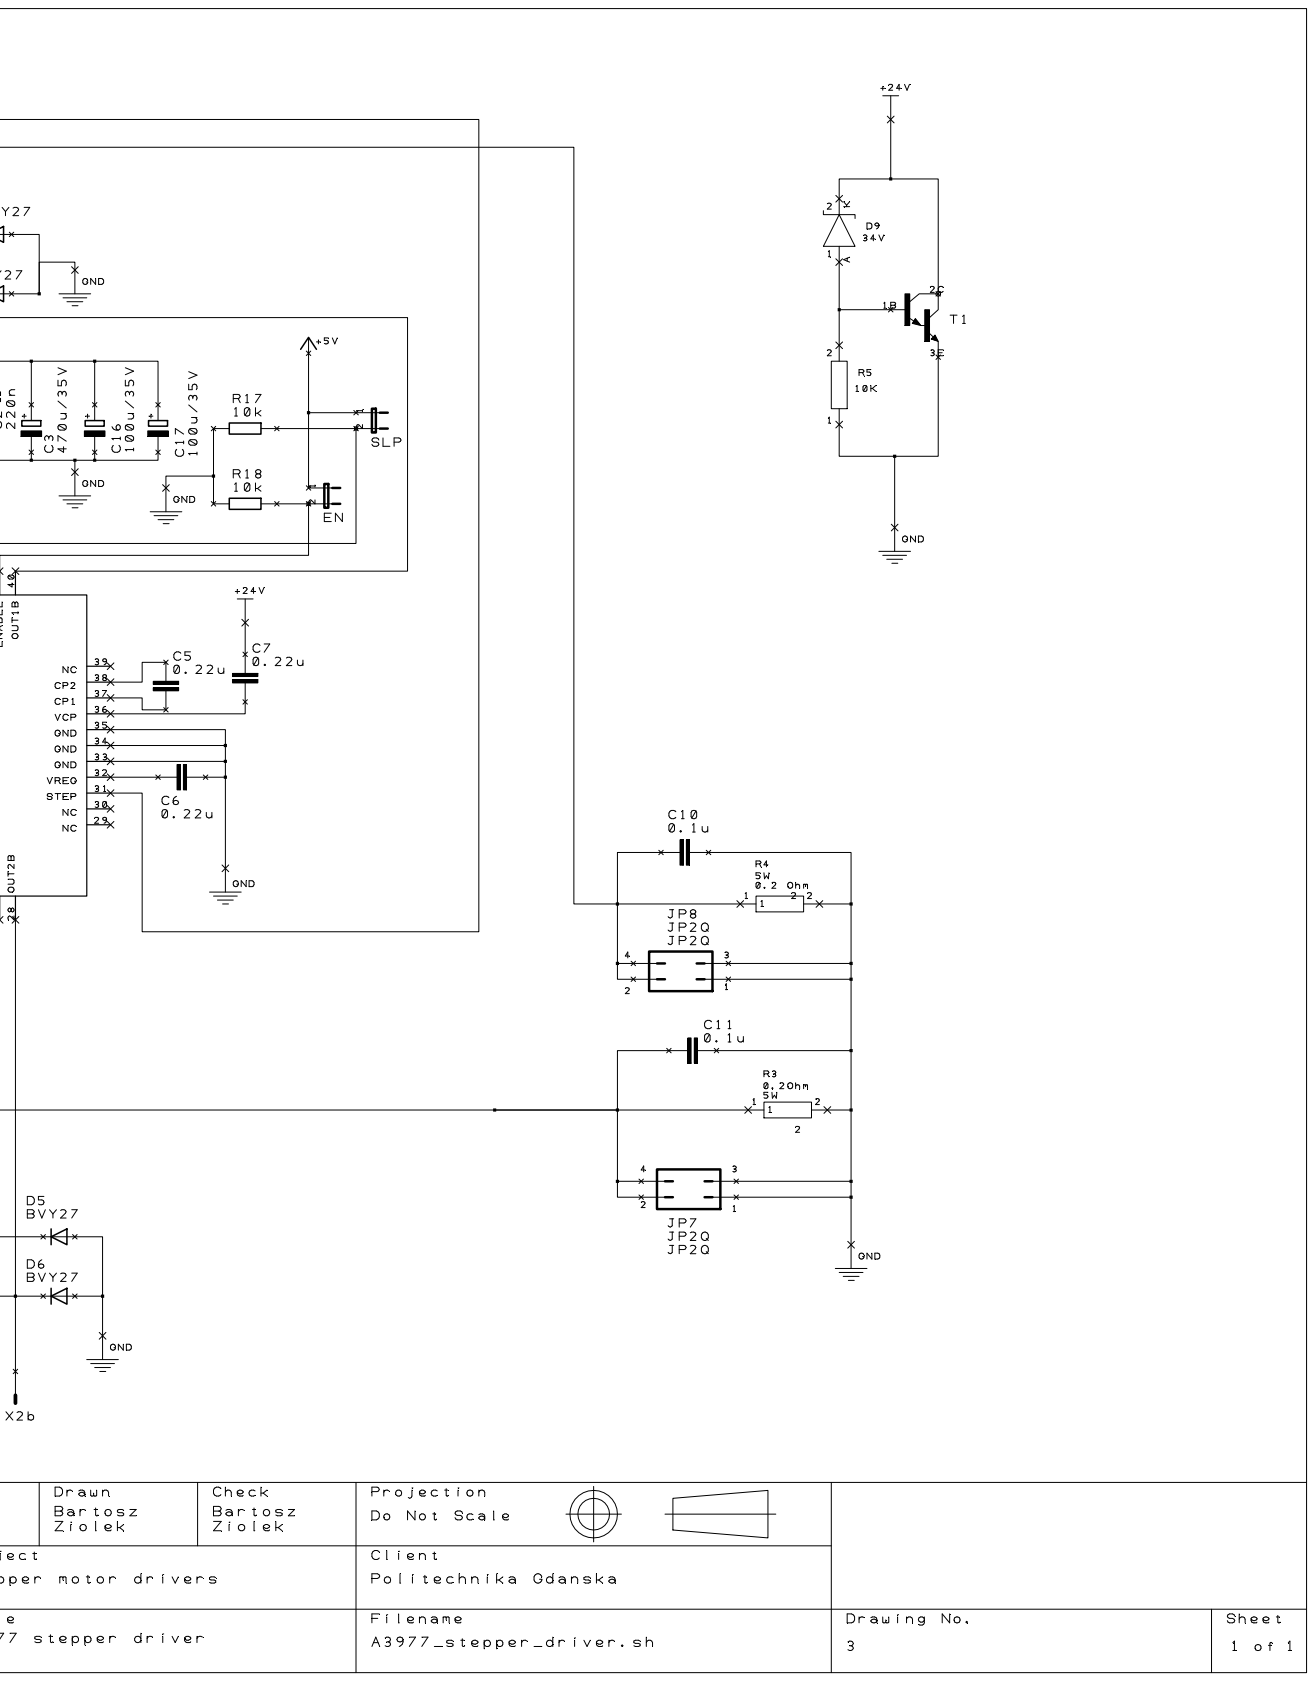
[picture p110: page 2]
