ziolman/robothand1234/projects/differential_amplifiers_sensors_multi/PCB Design_ differential_amplifiers_sensors_bottom.pdf

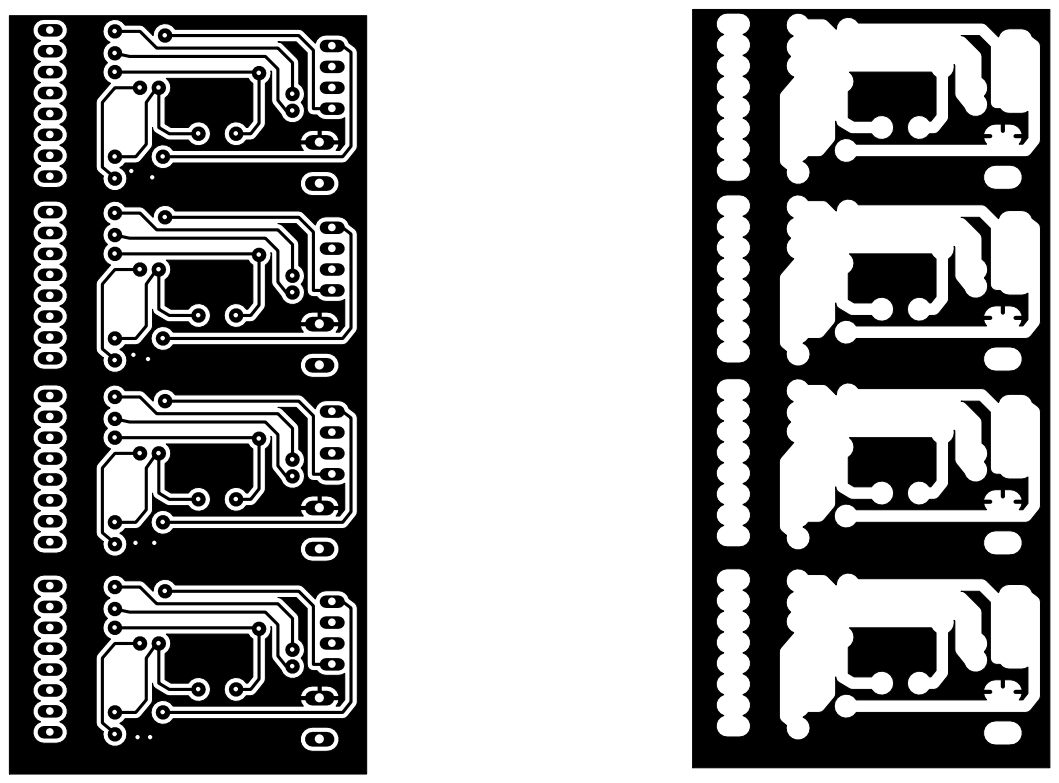
[picture p111: page 1]
