ziolman/robothand1234/projects/differential_amplifiers_sensors_multi/PCB Design_ differential_amplifiers_sensors_description.pdf

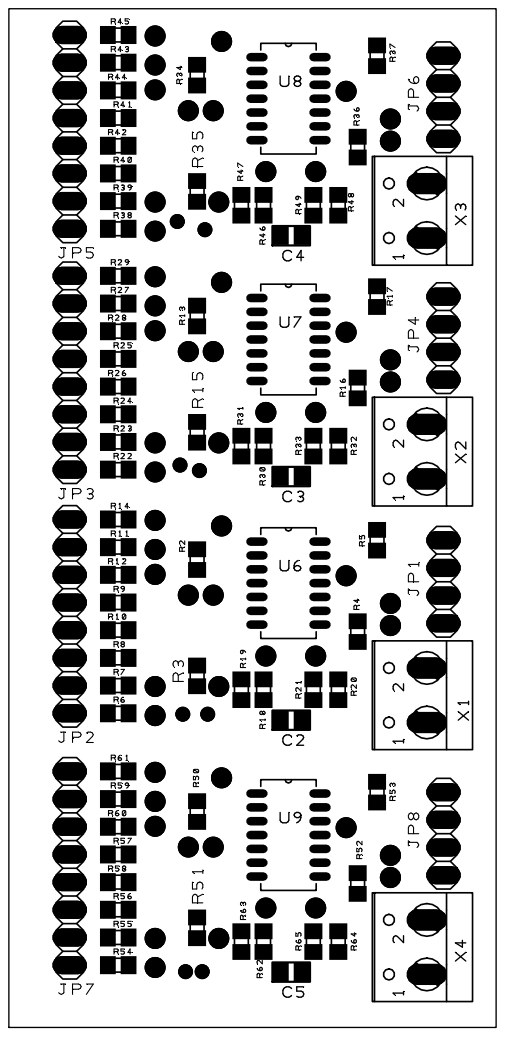
[picture p112: page 1]
