ziolman/robothand1234/projects/differential_amplifiers_sensors_multi/PCB Design_ differential_amplifiers_sensors_top.pdf

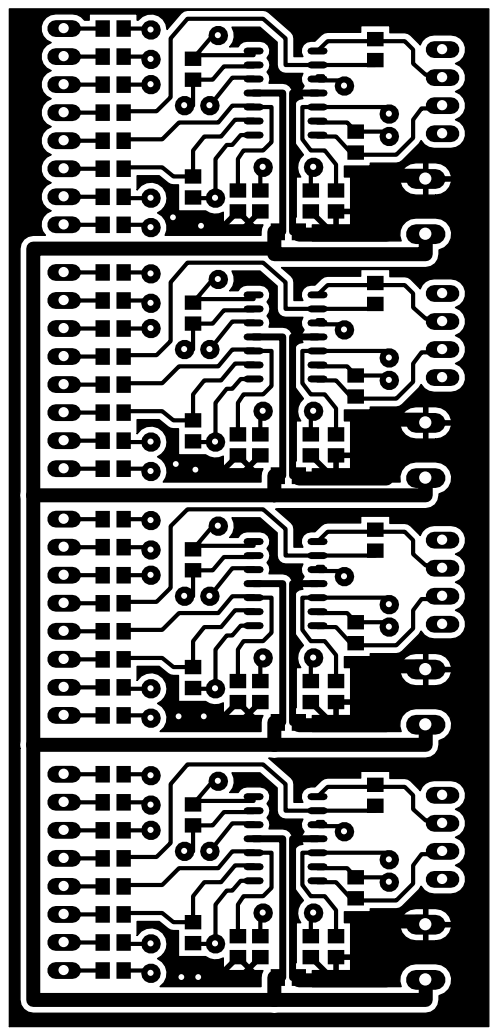
[picture p113: page 1]
