ziolman/robothand1234/projects/differential_amplifiers_sensors_multi/Schematic Design_ differential_amplifiers_sensors.pdf

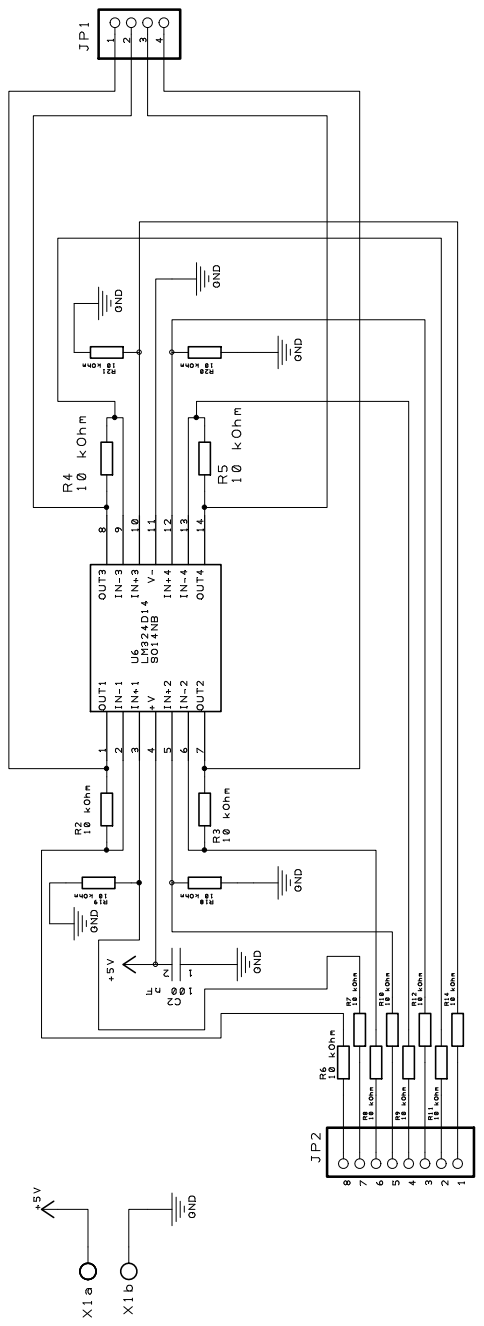
[picture p114: page 1]
