ziolman/robothand1234/projects/fan controller/PCB Design_ fan_controller_description.pdf

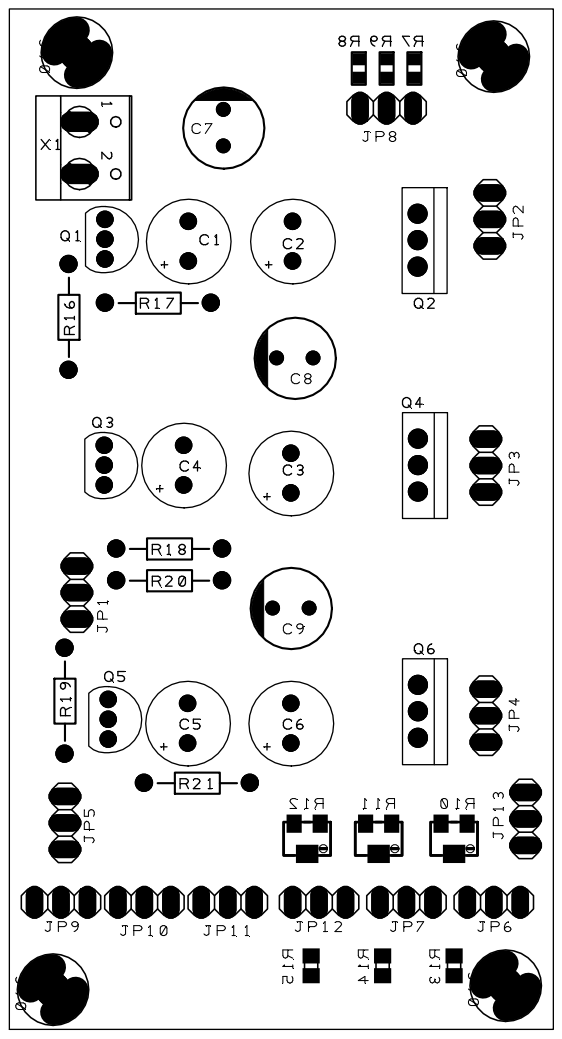
[picture p115: page 1]
