ziolman/robothand1234/projects/fan controller/PCB Design_ fan_controller_top.pdf

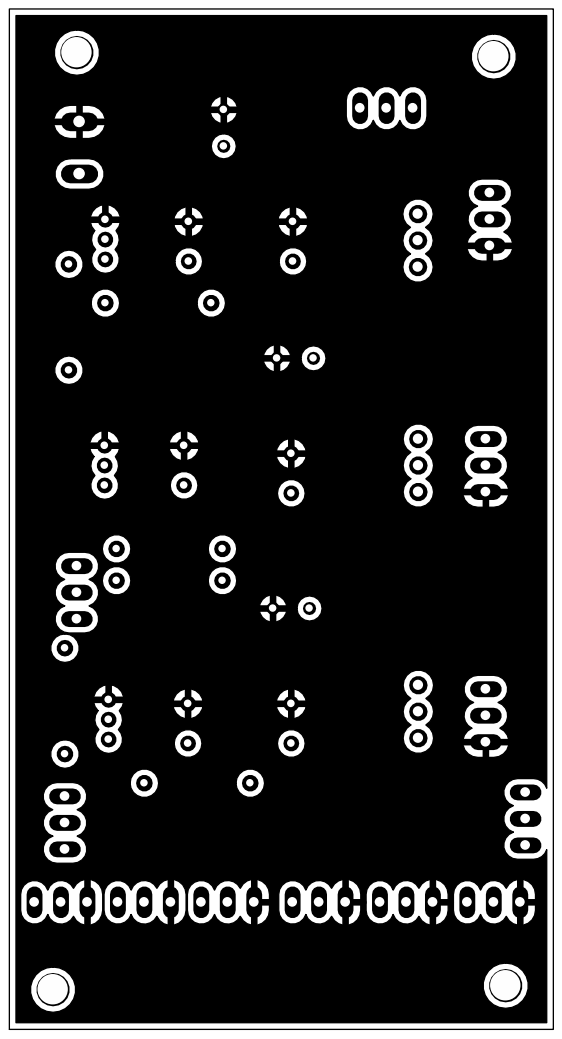
[picture p116: page 1]
