ziolman/robothand1234/projects/fan controller/Schematic Design_ fan_controller.pdf

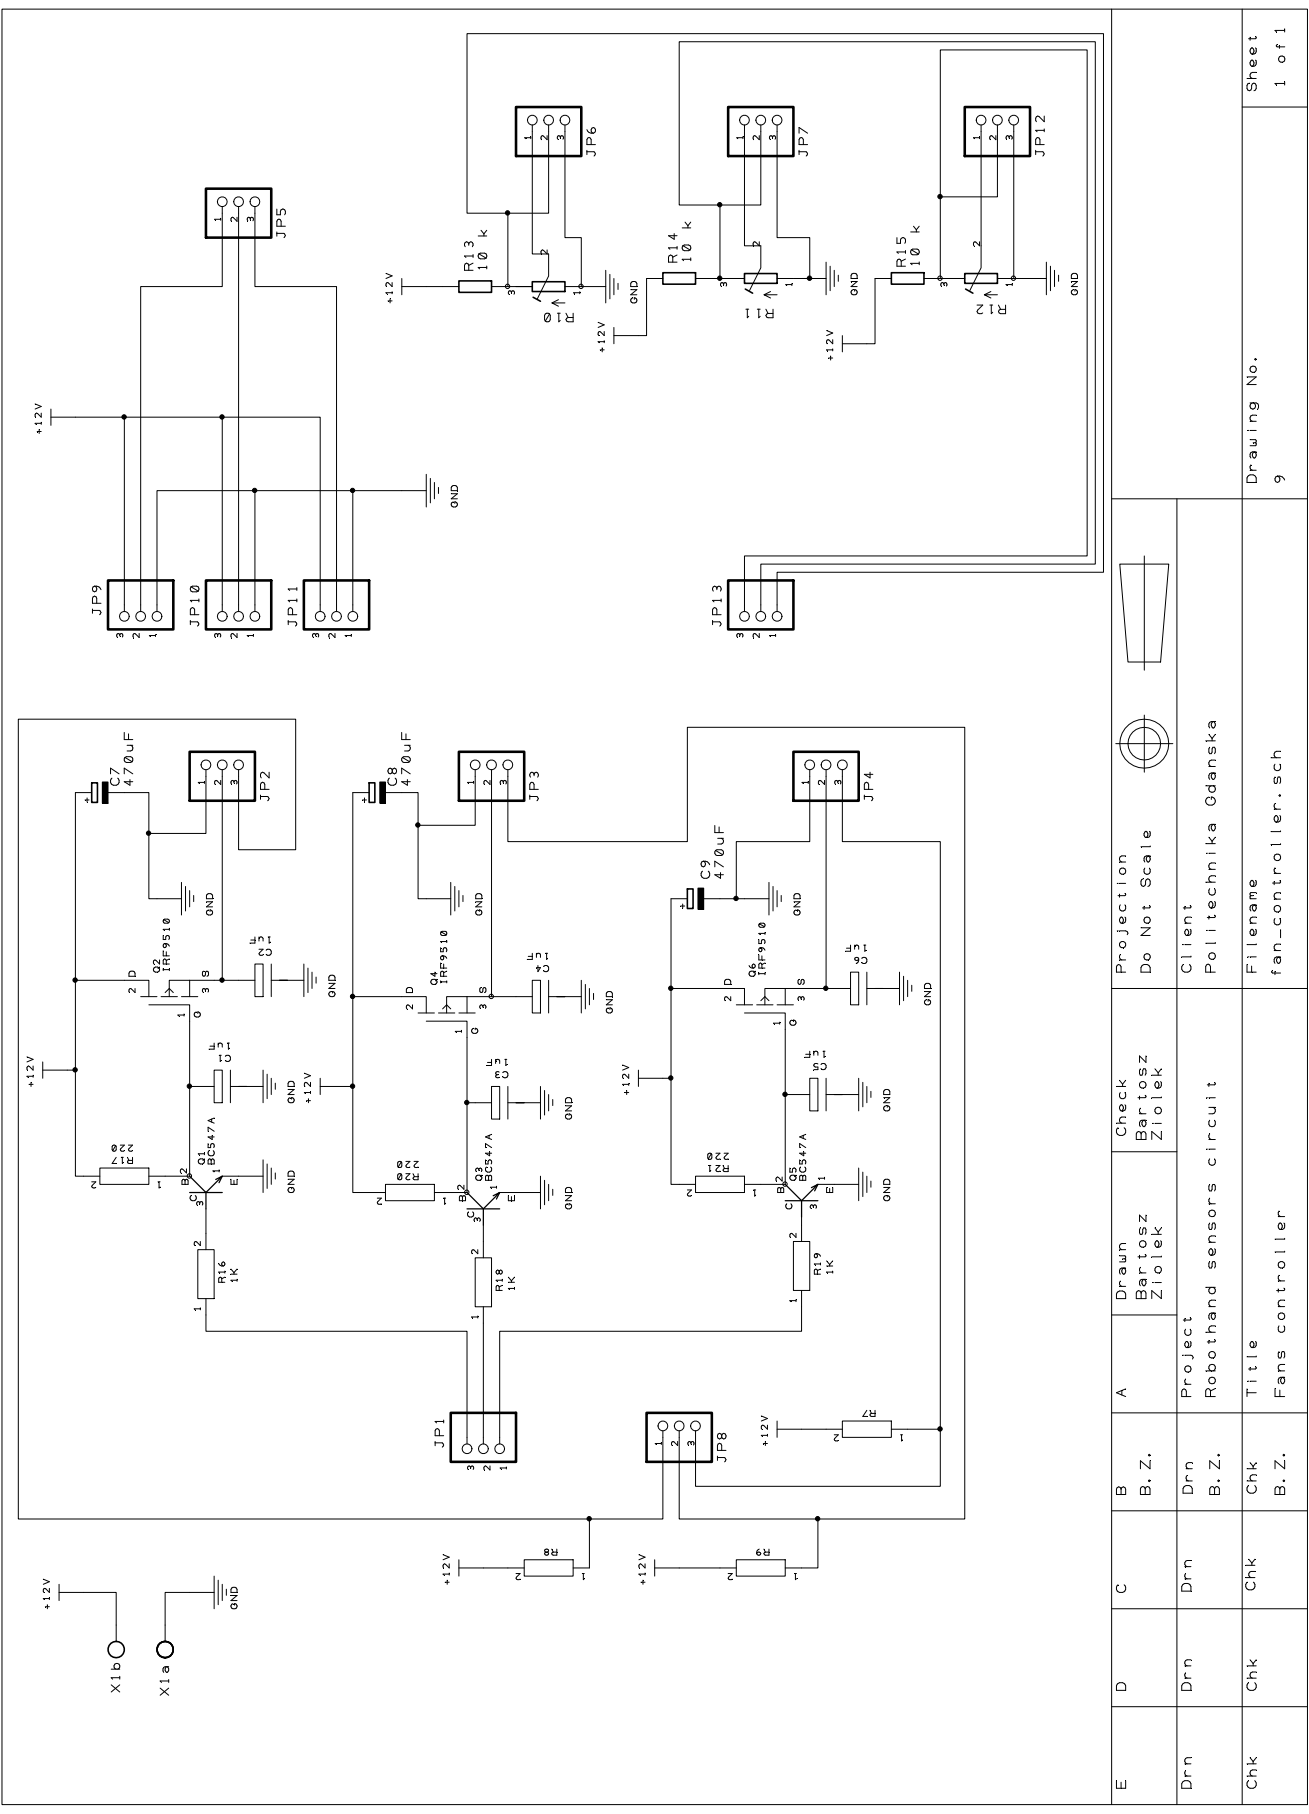
[picture p117: page 1]
