ziolman/robothand1234/projects/magnetic_sensors_circuit/PCB Design_ magnetic_sensors_circuit.pdf

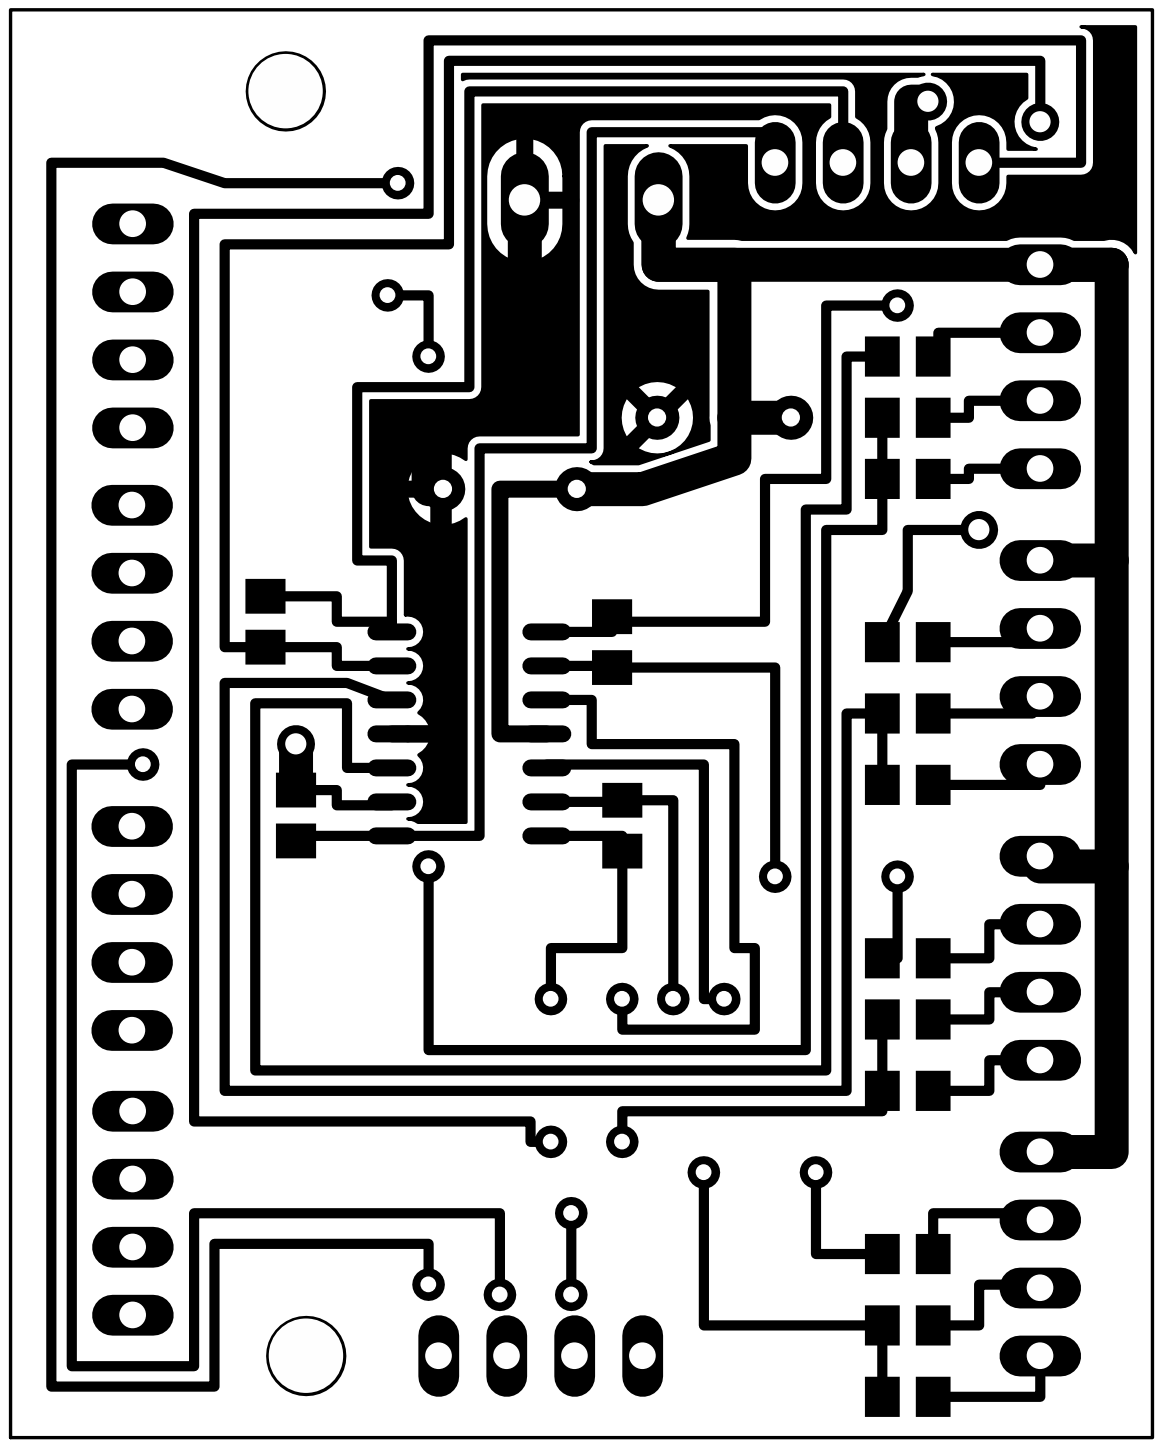
[picture p118: page 1]
