ziolman/robothand1234/projects/magnetic_sensors_circuit/PCB Design_ magnetic_sensors_circuit_bottom.pdf

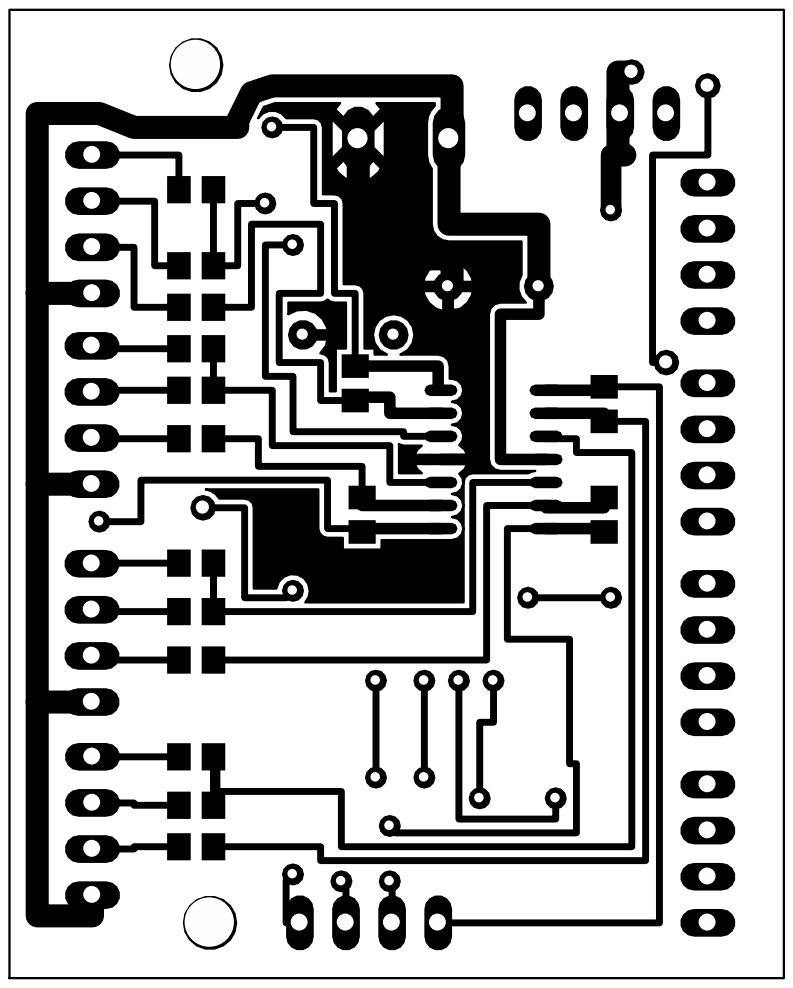
[picture p119: page 1]
