ziolman/robothand1234/projects/magnetic_sensors_circuit/PCB Design_ magnetic_sensors_circuit_description.pdf

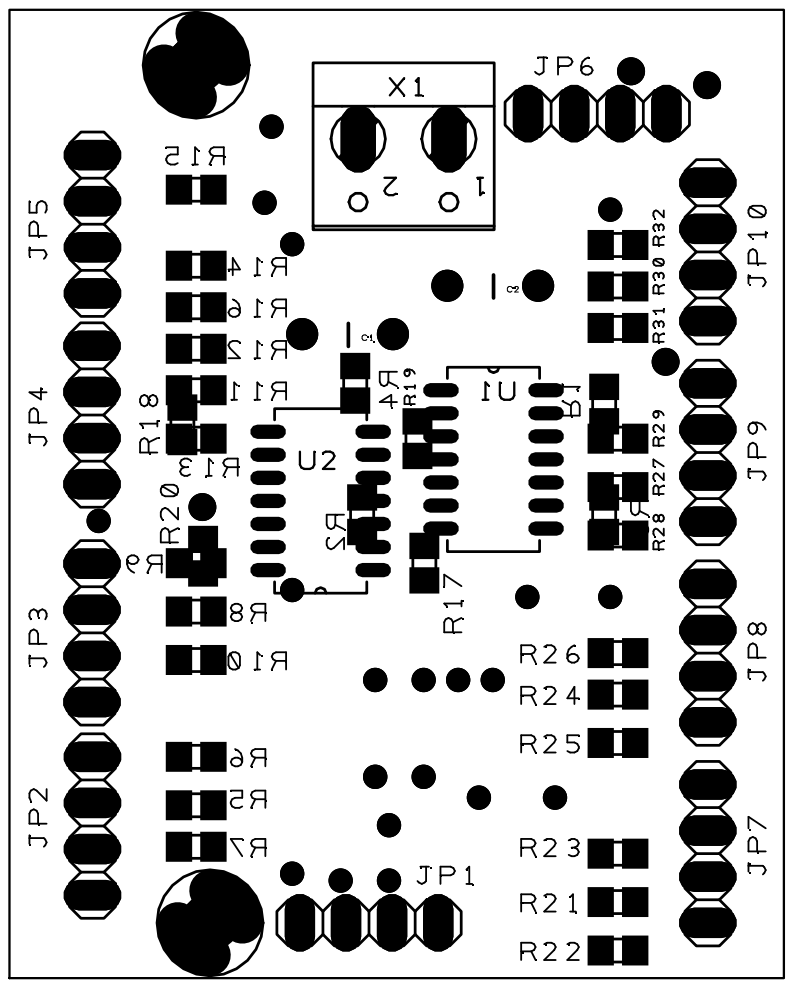
[picture p120: page 1]
