ziolman/robothand1234/projects/magnetic_sensors_circuit/PCB Design_ magnetic_sensors_circuit_top.pdf

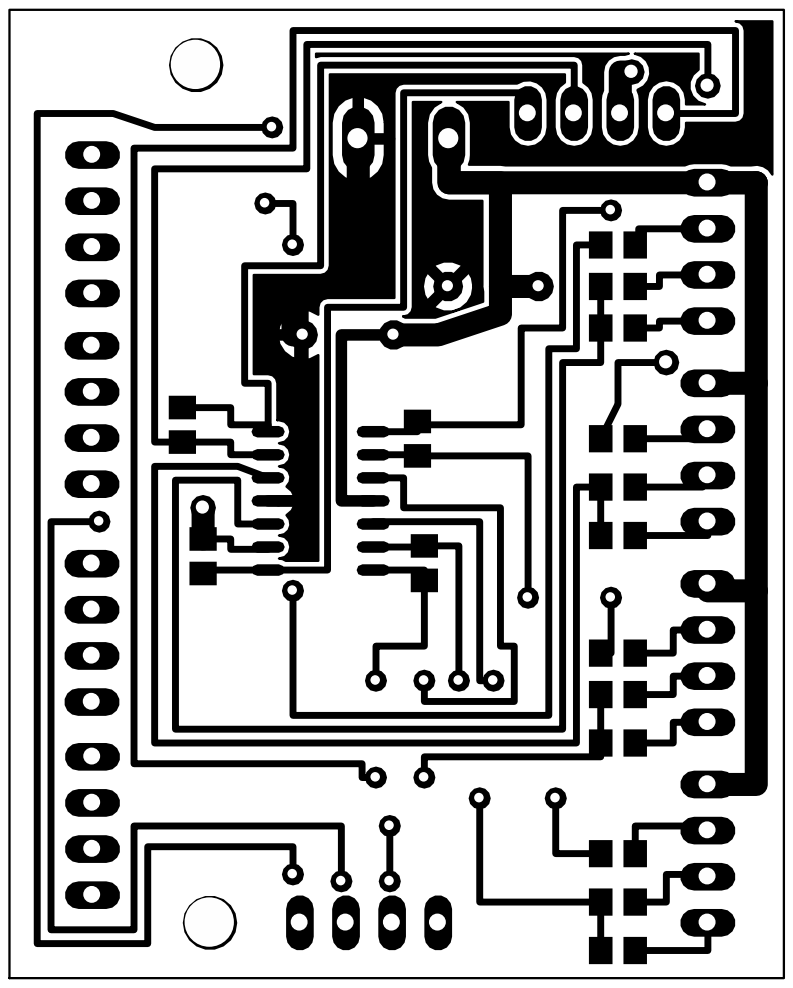
[picture p121: page 1]
