ziolman/robothand1234/projects/magnetic_sensors_circuit/Schematic Design_ magnetic_sensors_circuit.pdf

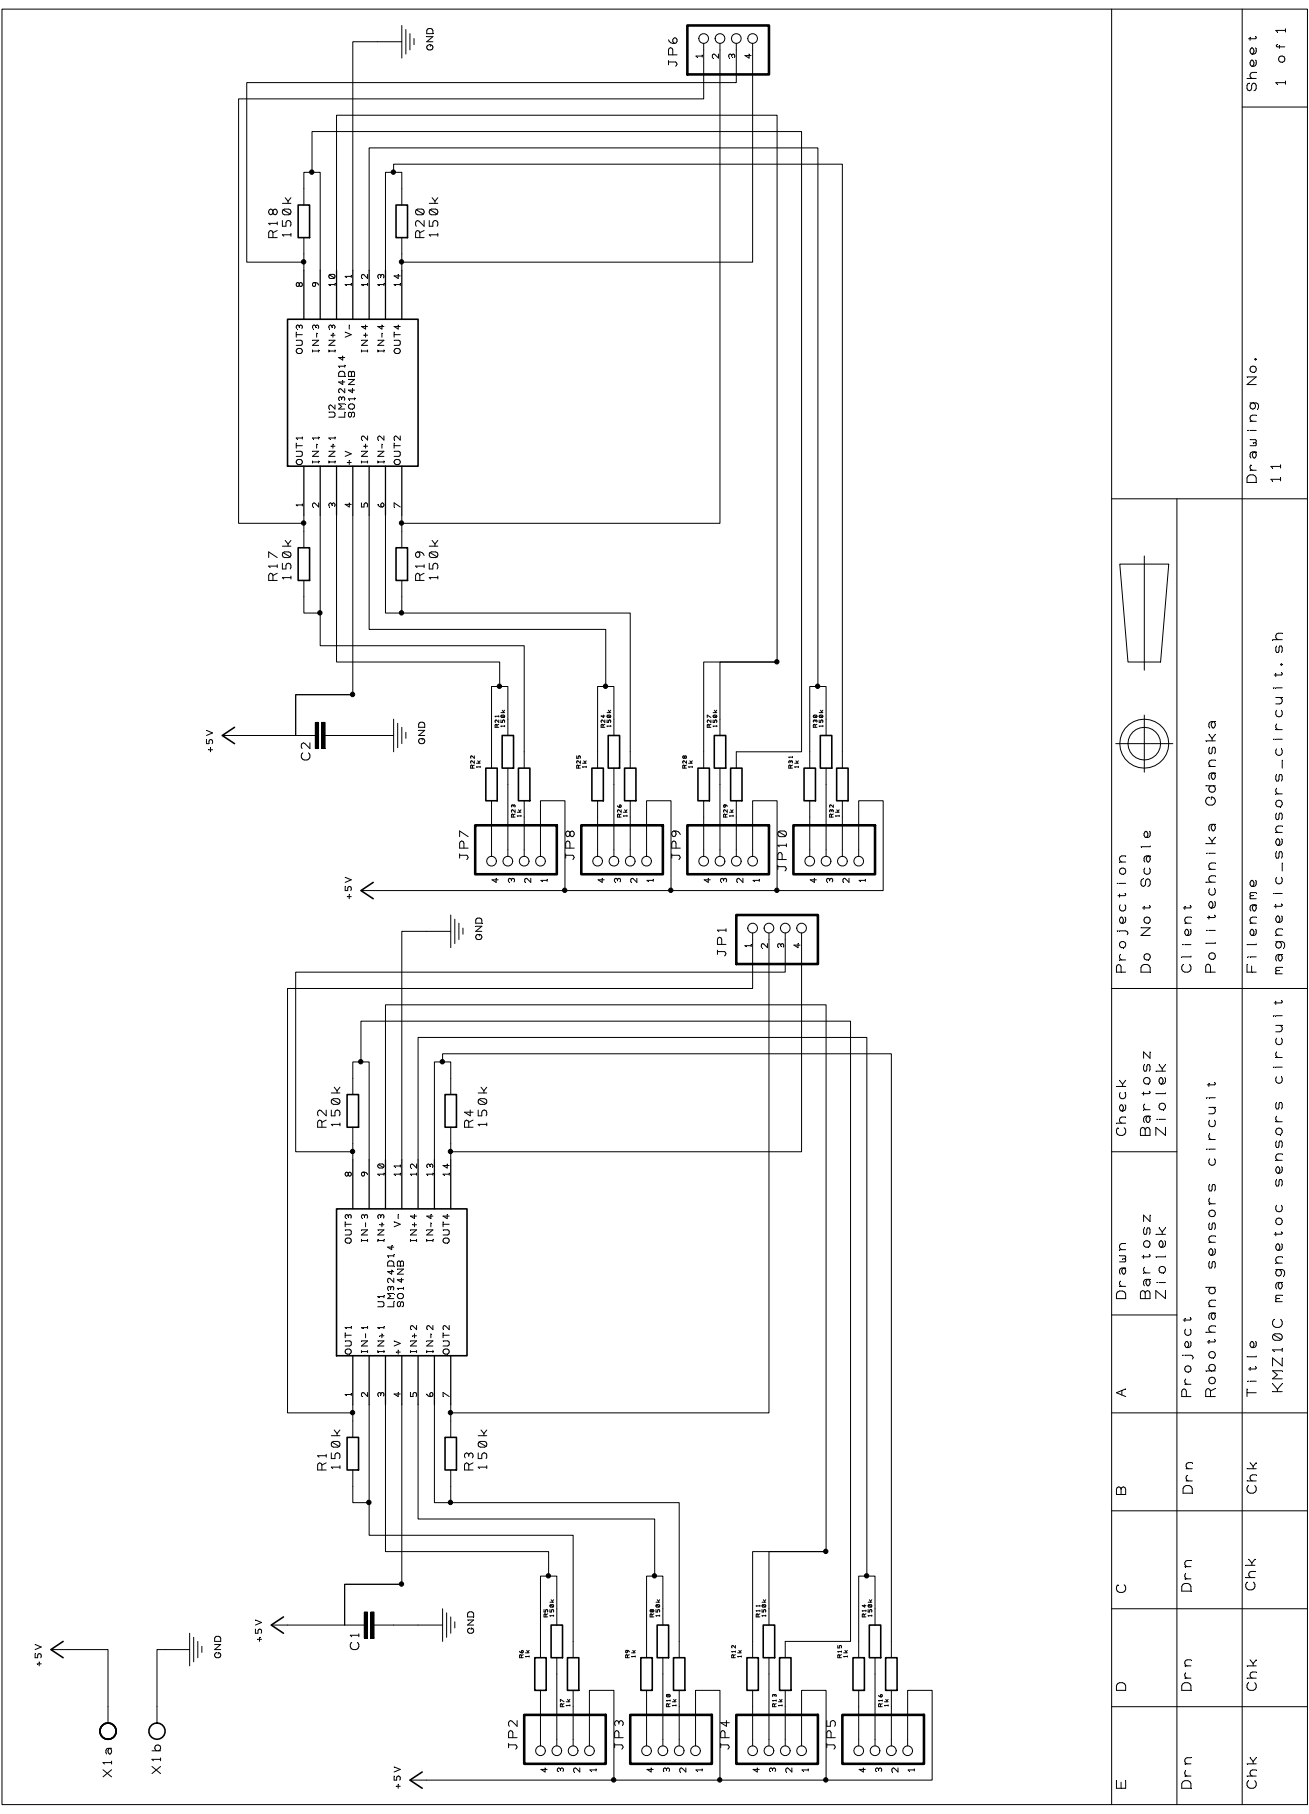
[picture p122: page 1]
