ziolman/robothand1234/projects/sensor_system_circuit/PCB Design_ sensor_system_circuit_bottom.pdf

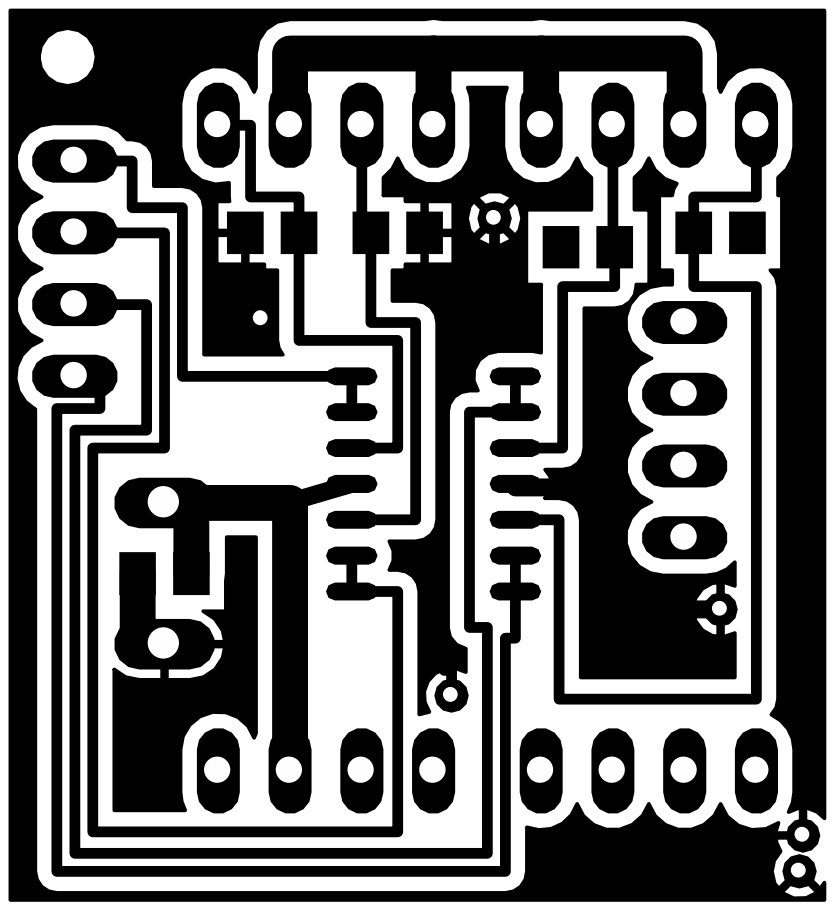
[picture p123: page 1]
