ziolman/robothand1234/projects/sensor_system_circuit/PCB Design_ sensor_system_circuit_description.pdf

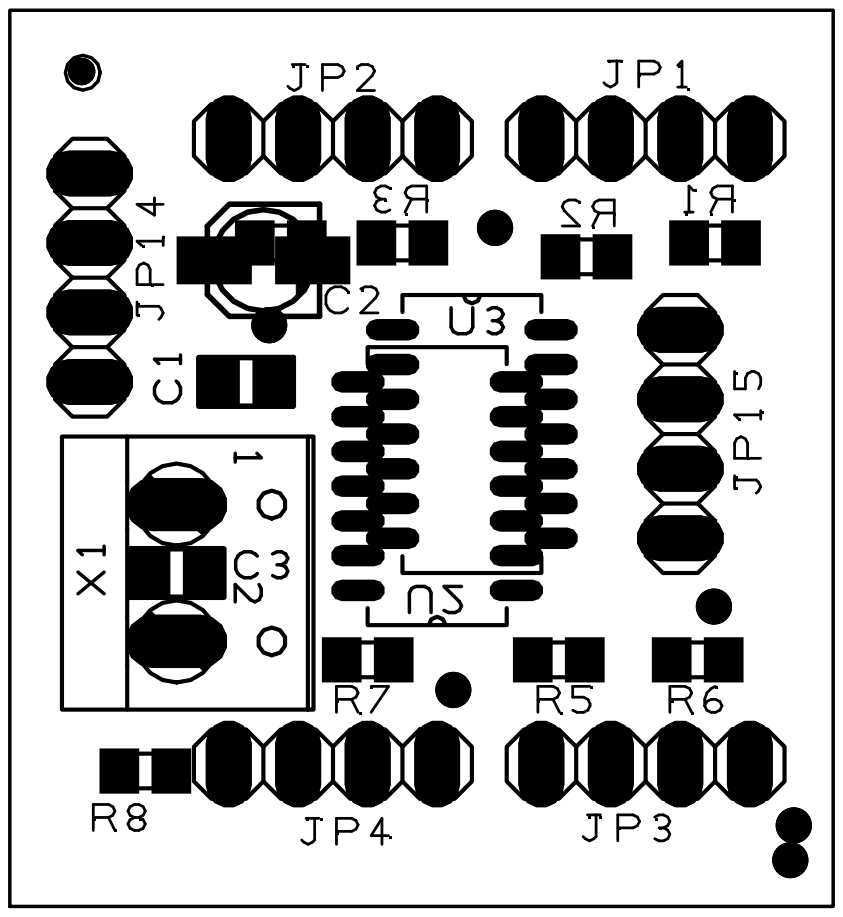
[picture p124: page 1]
