ziolman/robothand1234/projects/sensor_system_circuit/PCB Design_ sensor_system_circuit_top.pdf

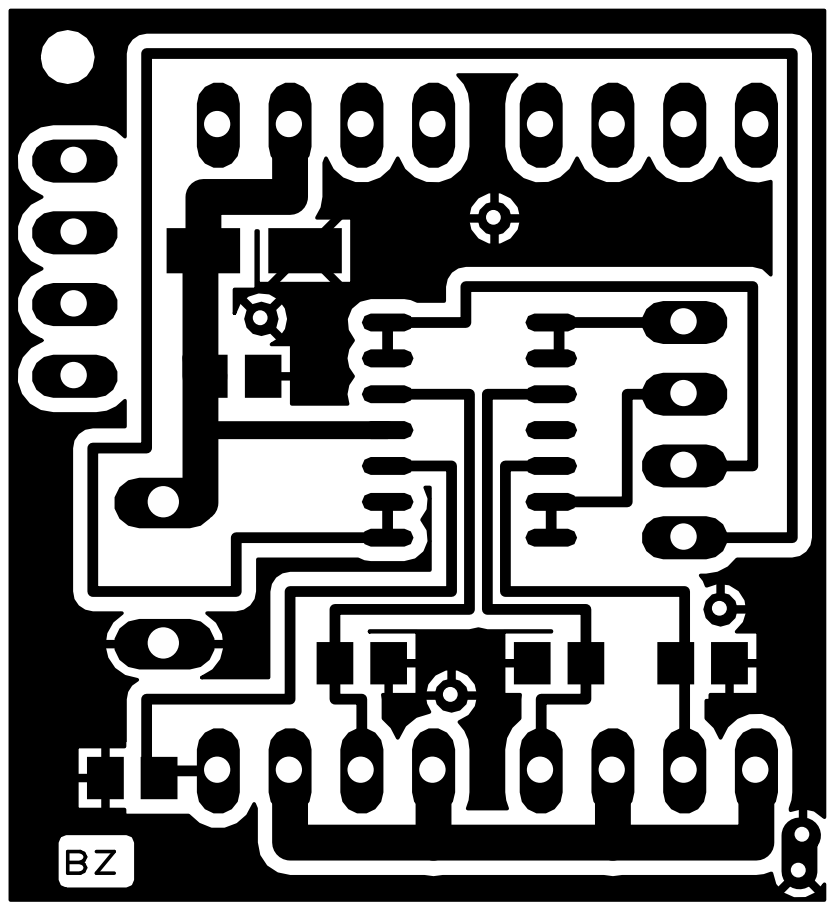
[picture p125: page 1]
