ziolman/robothand1234/projects/sensor_system_circuit/Schematic Design_ sensor_system_circuit.pdf

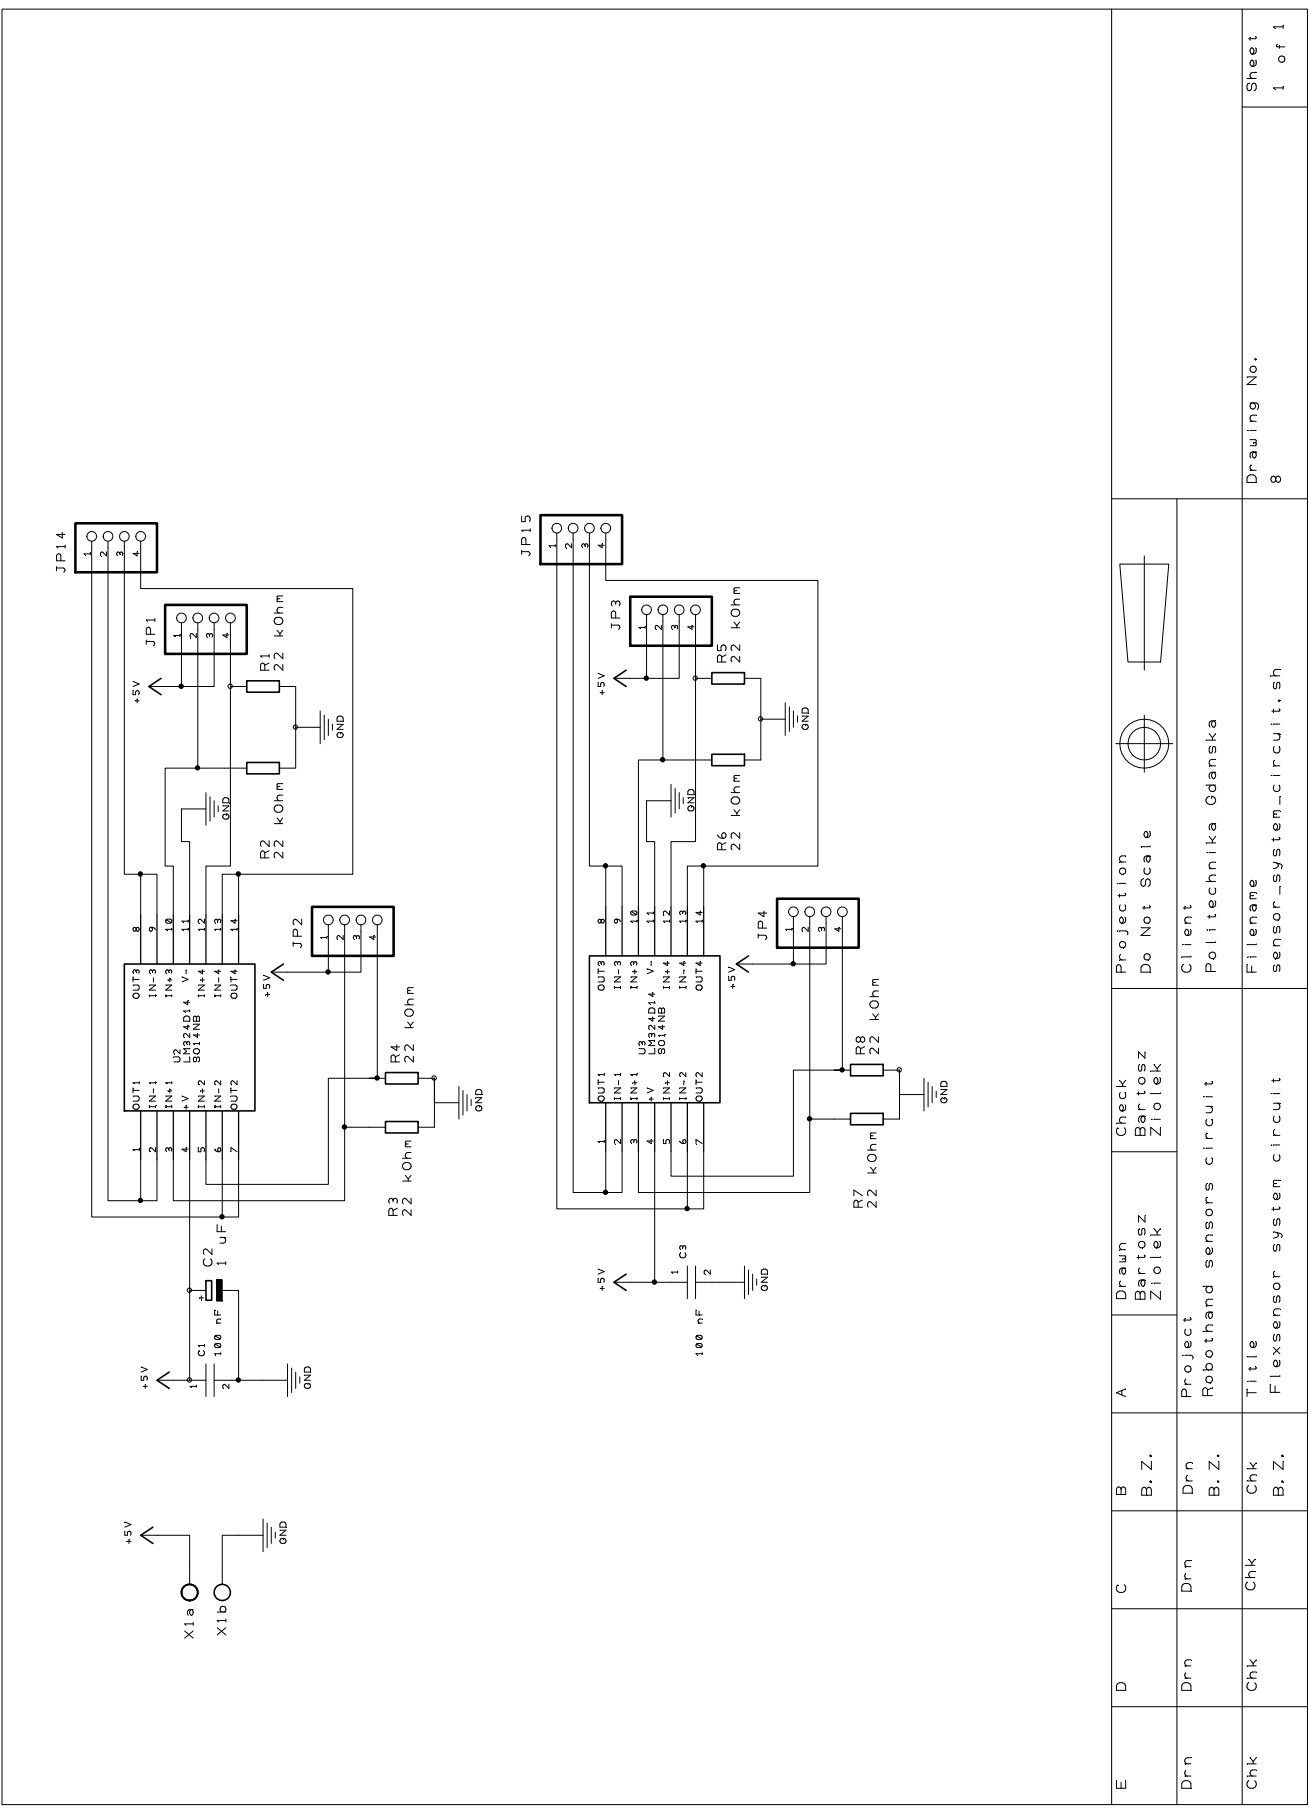
[picture p126: page 1]
