ziolman/robothand1234/projects/ss49_magnetic_sensors_circuit/PCB Design_ ss49_magnetic_sensors_circuit_bottom.pdf

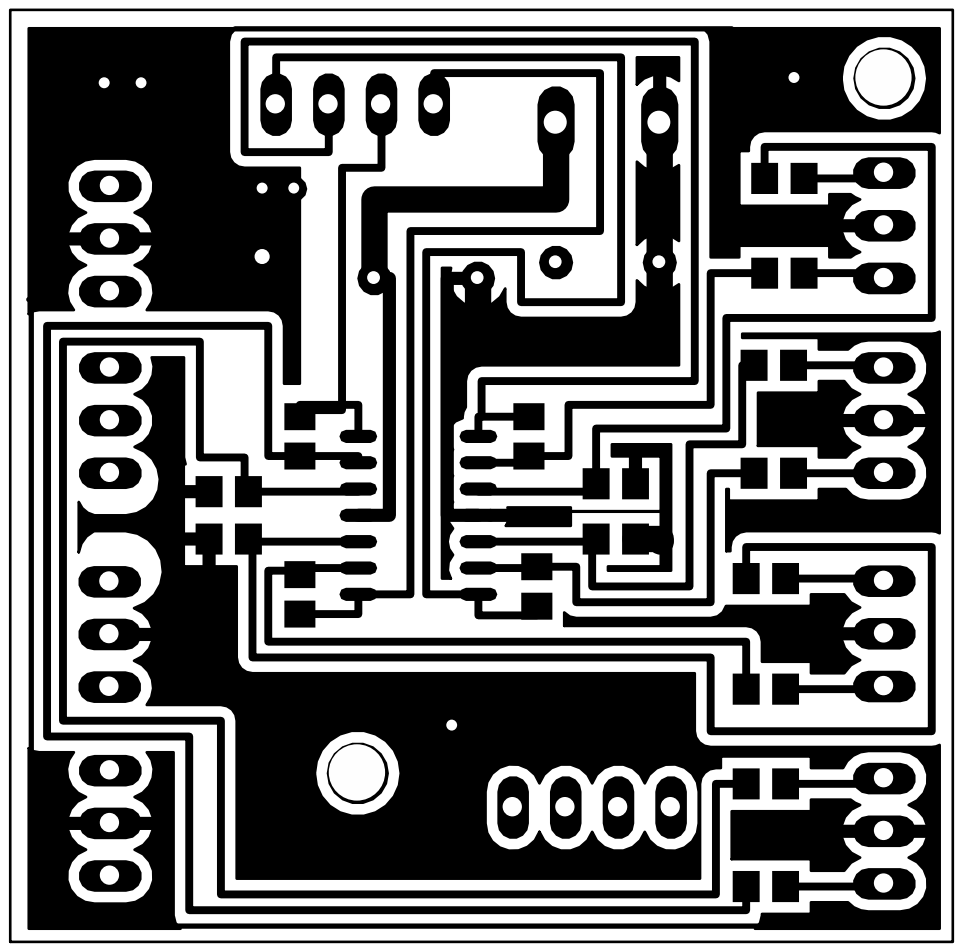
[picture p127: page 1]
