ziolman/robothand1234/projects/ss49_magnetic_sensors_circuit/PCB Design_ ss49_magnetic_sensors_circuit_description.pdf

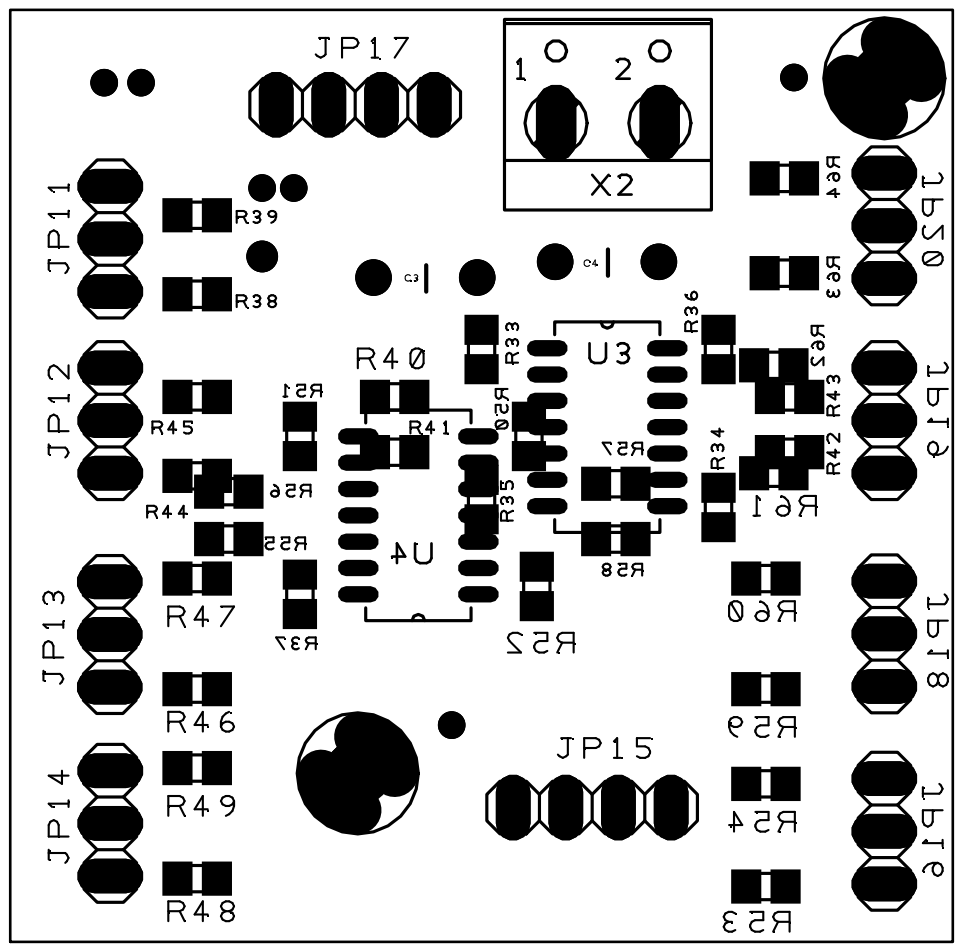
[picture p128: page 1]
