ziolman/robothand1234/projects/ss49_magnetic_sensors_circuit/PCB Design_ ss49_magnetic_sensors_circuit_top.pdf

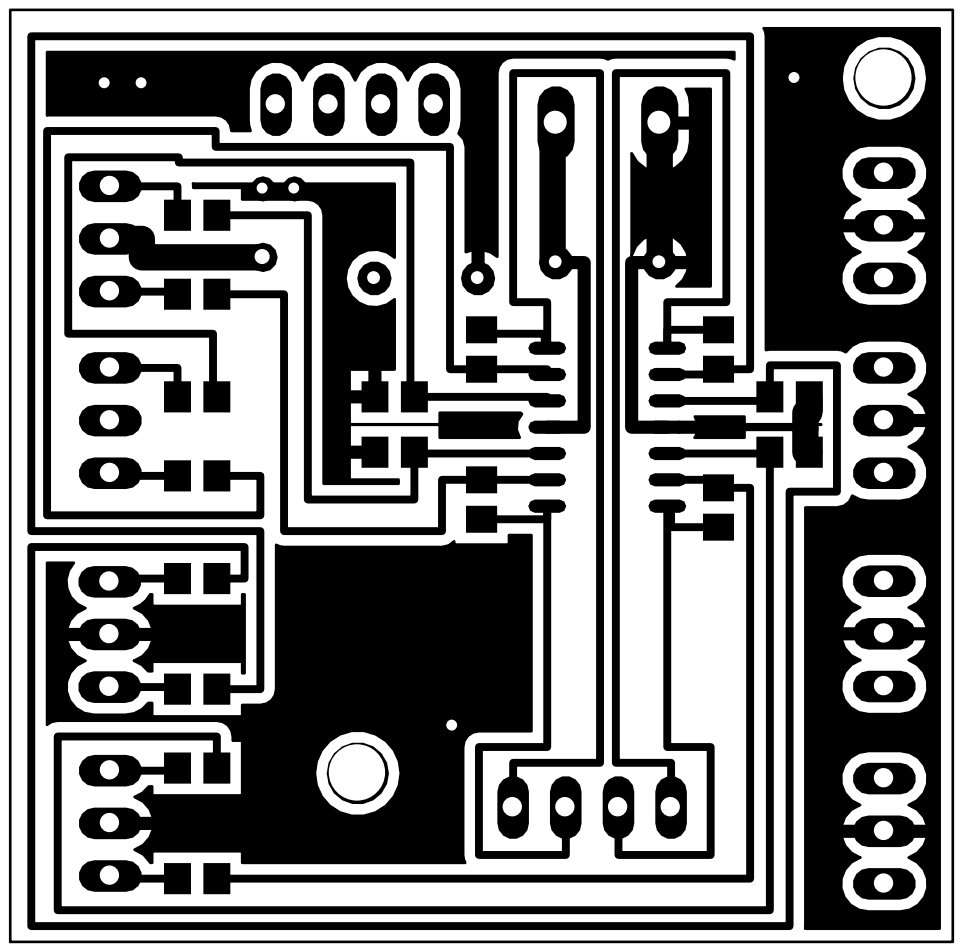
[picture p129: page 1]
