ziolman/robothand1234/projects/ss49_magnetic_sensors_circuit/Schematic Design_ ss49_magnetic_sensor_circuit.pdf

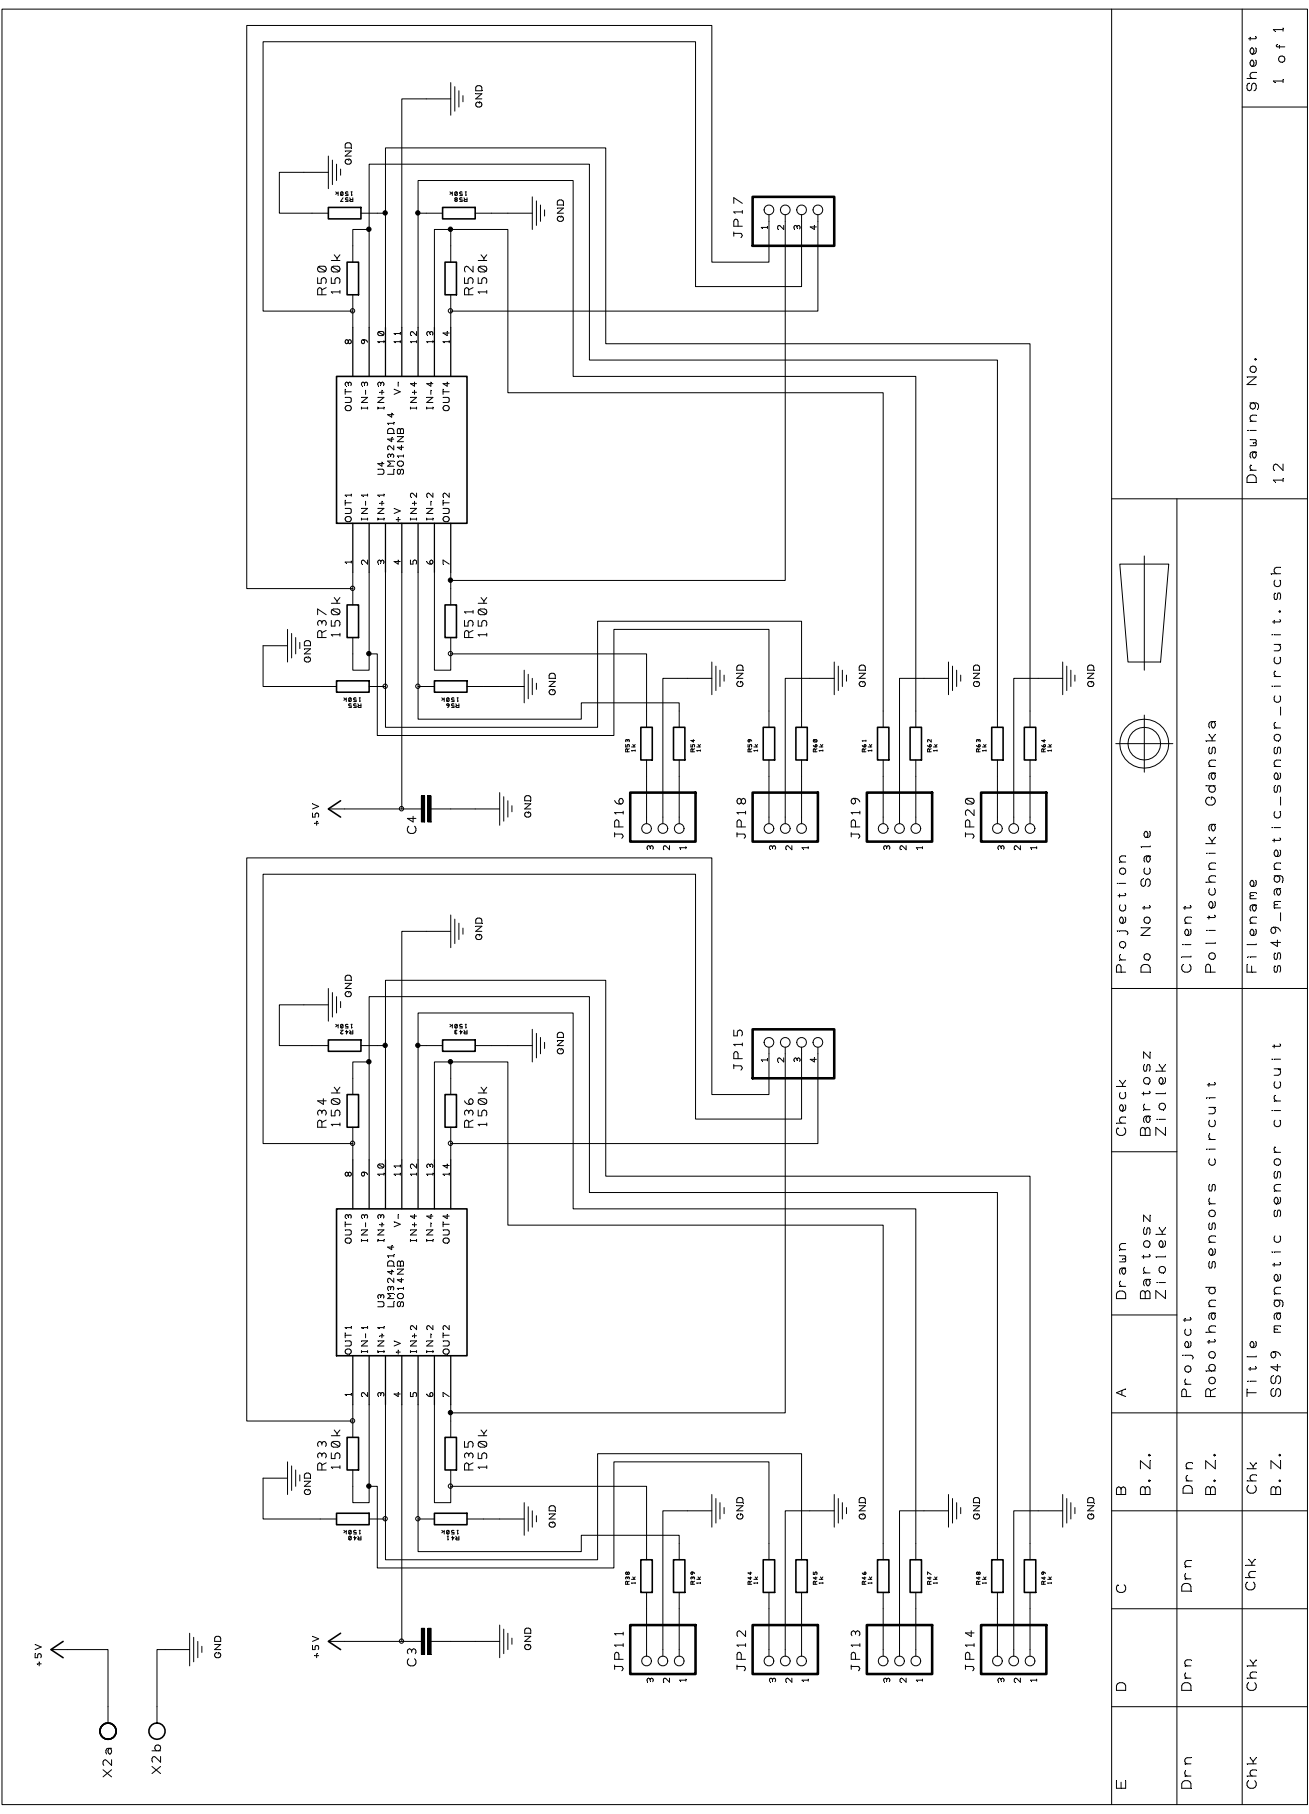
[picture p130: page 1]
