ziolman/robothand1234/projects/stepper_motor_translator_driver/PCB Design_ stepper_motor_translator_driver_bottom.pdf

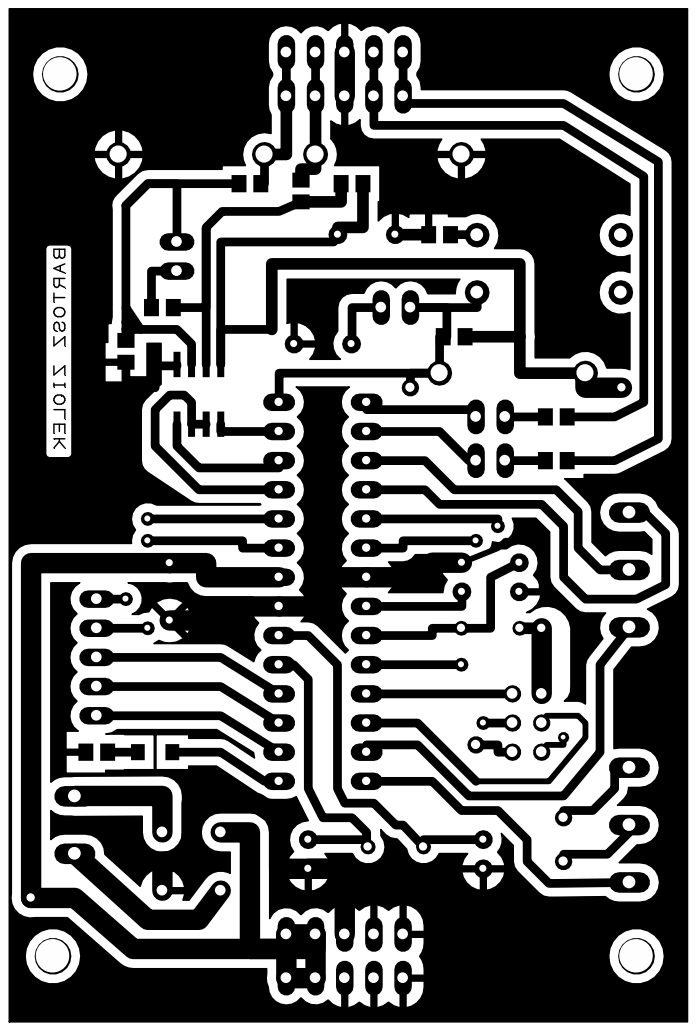
[picture p131: page 1]
