ziolman/robothand1234/projects/stepper_motor_translator_driver/PCB Design_ stepper_motor_translator_driver_description.pdf

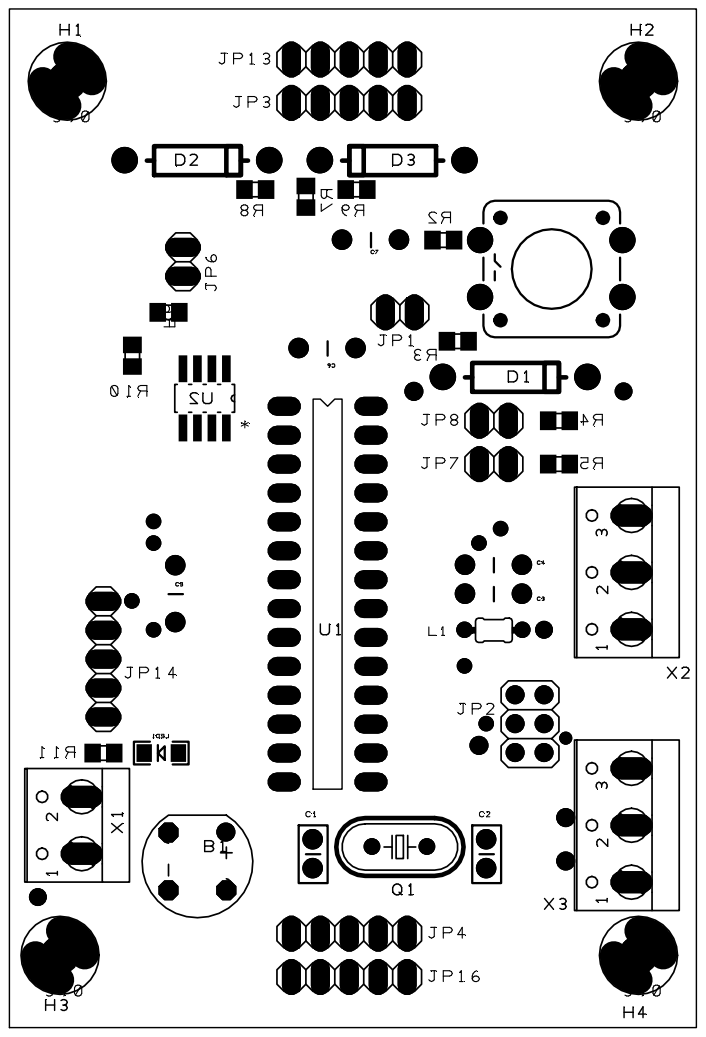
[picture p132: page 1]
