ziolman/robothand1234/projects/stepper_motor_translator_driver/PCB Design_ stepper_motor_translator_driver_top.pdf

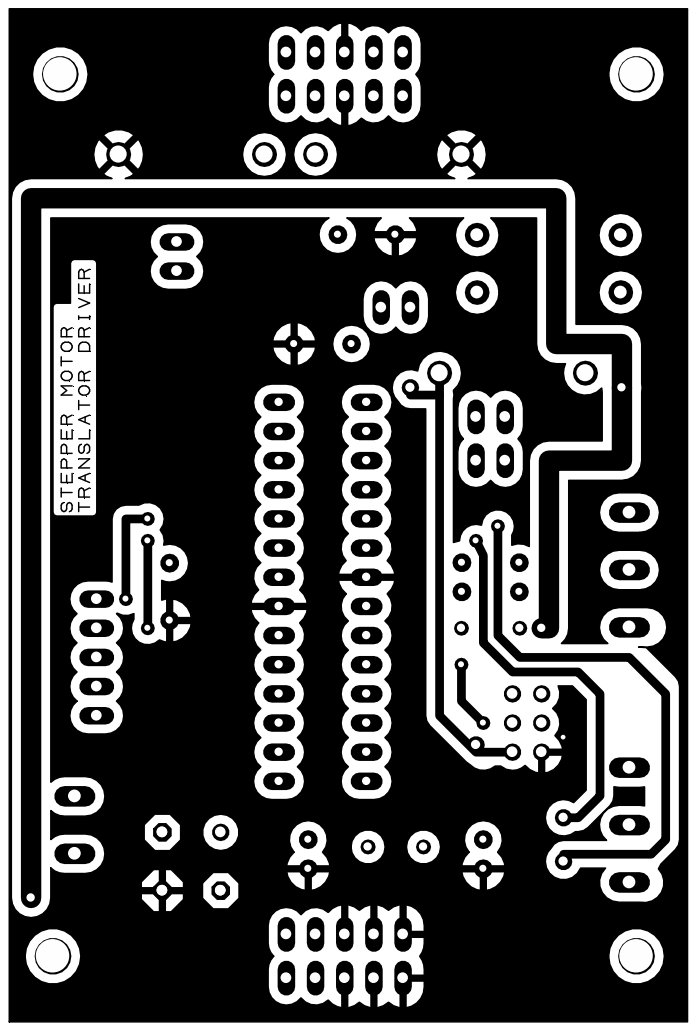
[picture p133: page 1]
