ziolman/robothand1234/projects/uart_rs485/PCB Design_ uart_rs485.pdf

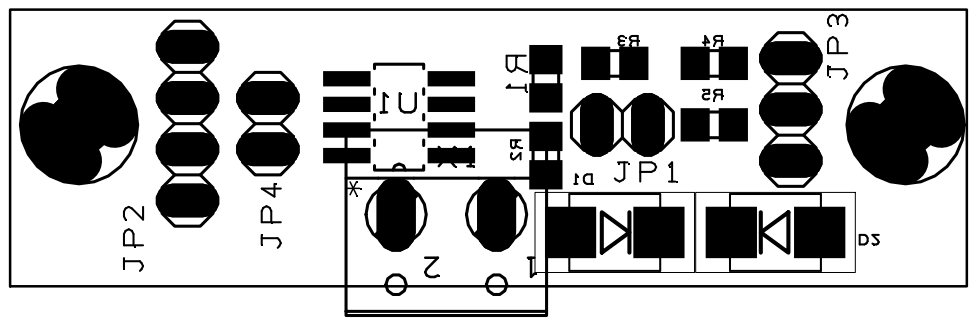
[picture p134: page 1]
