ziolman/robothand1234/projects/uart_rs485/PCB Design_ uart_rs485_bottom.pdf

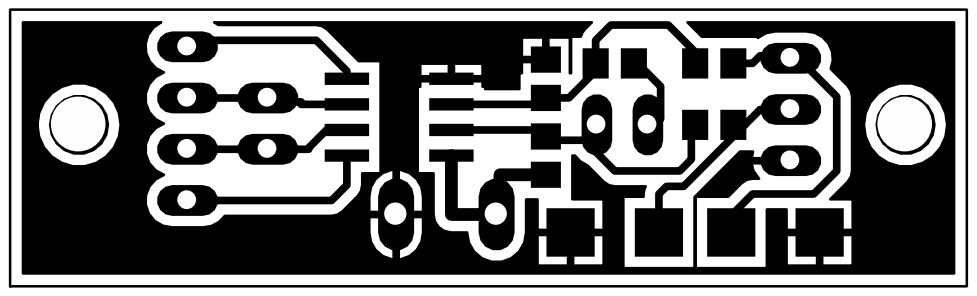
[picture p135: page 1]
