ziolman/robothand1234/projects/uart_rs485/PCB Design_ uart_rs485_top.pdf

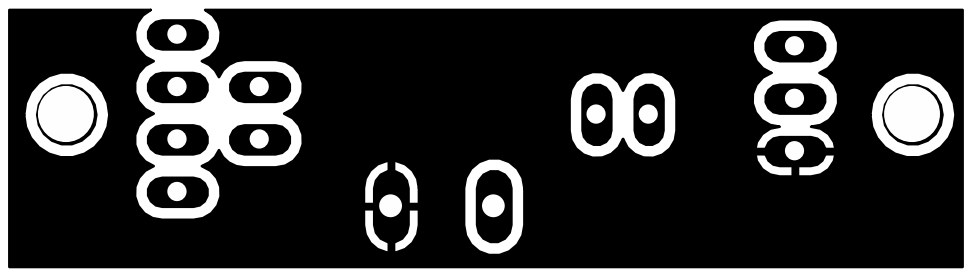
[picture p136: page 1]
