ziolman/robothand1234/projects/uart_rs485/Schematic Design_ uart_rs485.pdf

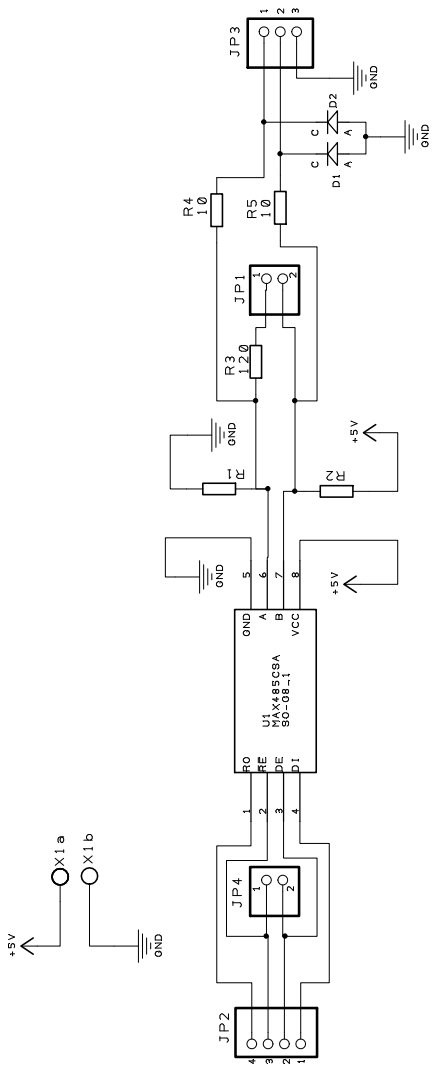
[picture p137: page 1]
