ziolman/robothand1234/projects/A3977_stepper_driver_second/A3977_stepper_driver - Schematic.pdf

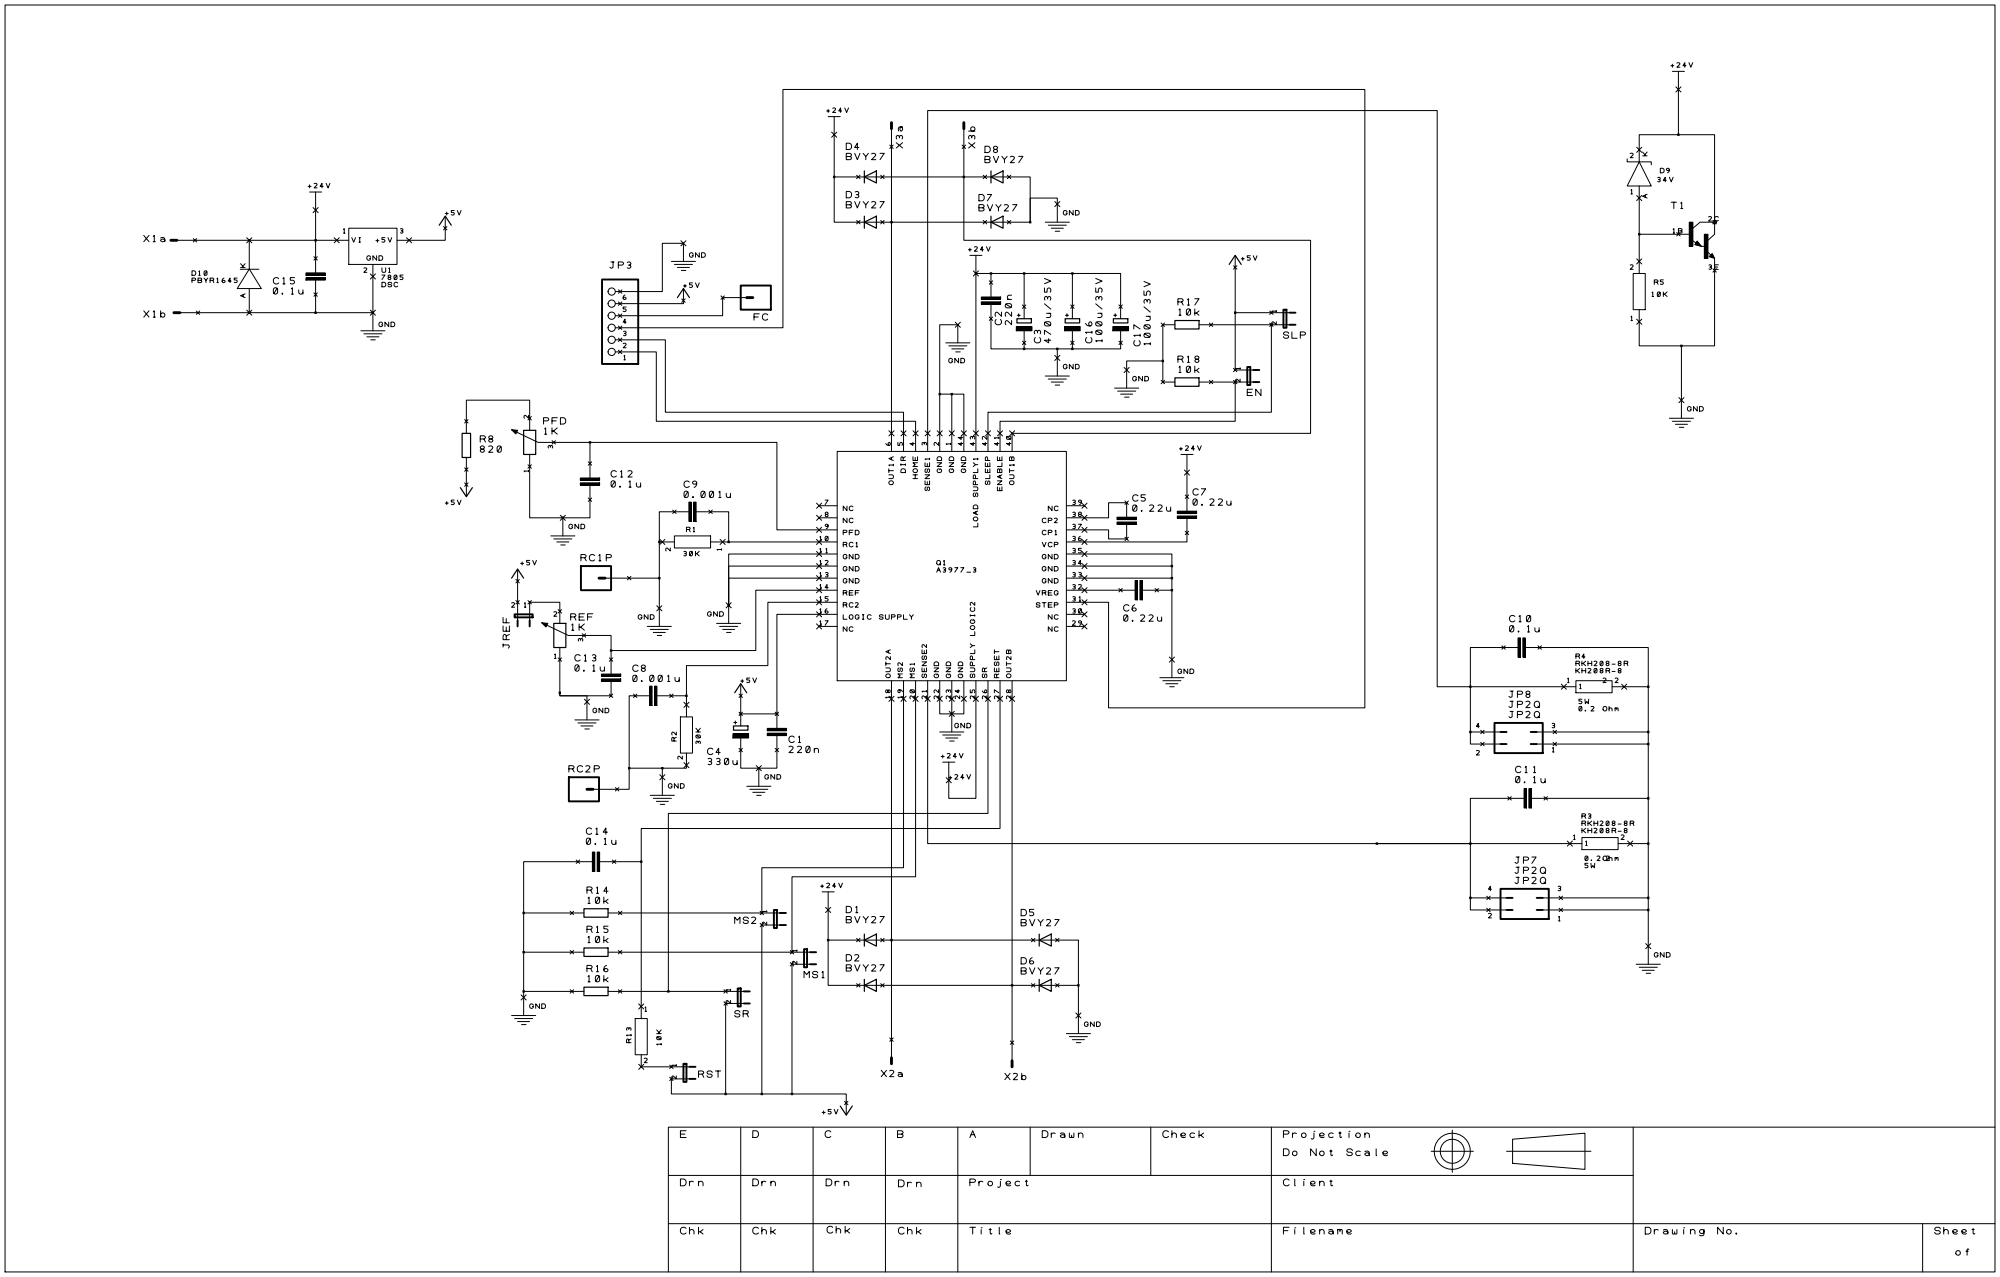
[picture p138: page 1]
