ziolman/robothand1234/projects/stepper_motor_translator_driver/stepper_motor_translator_driver - Schematic.pdf

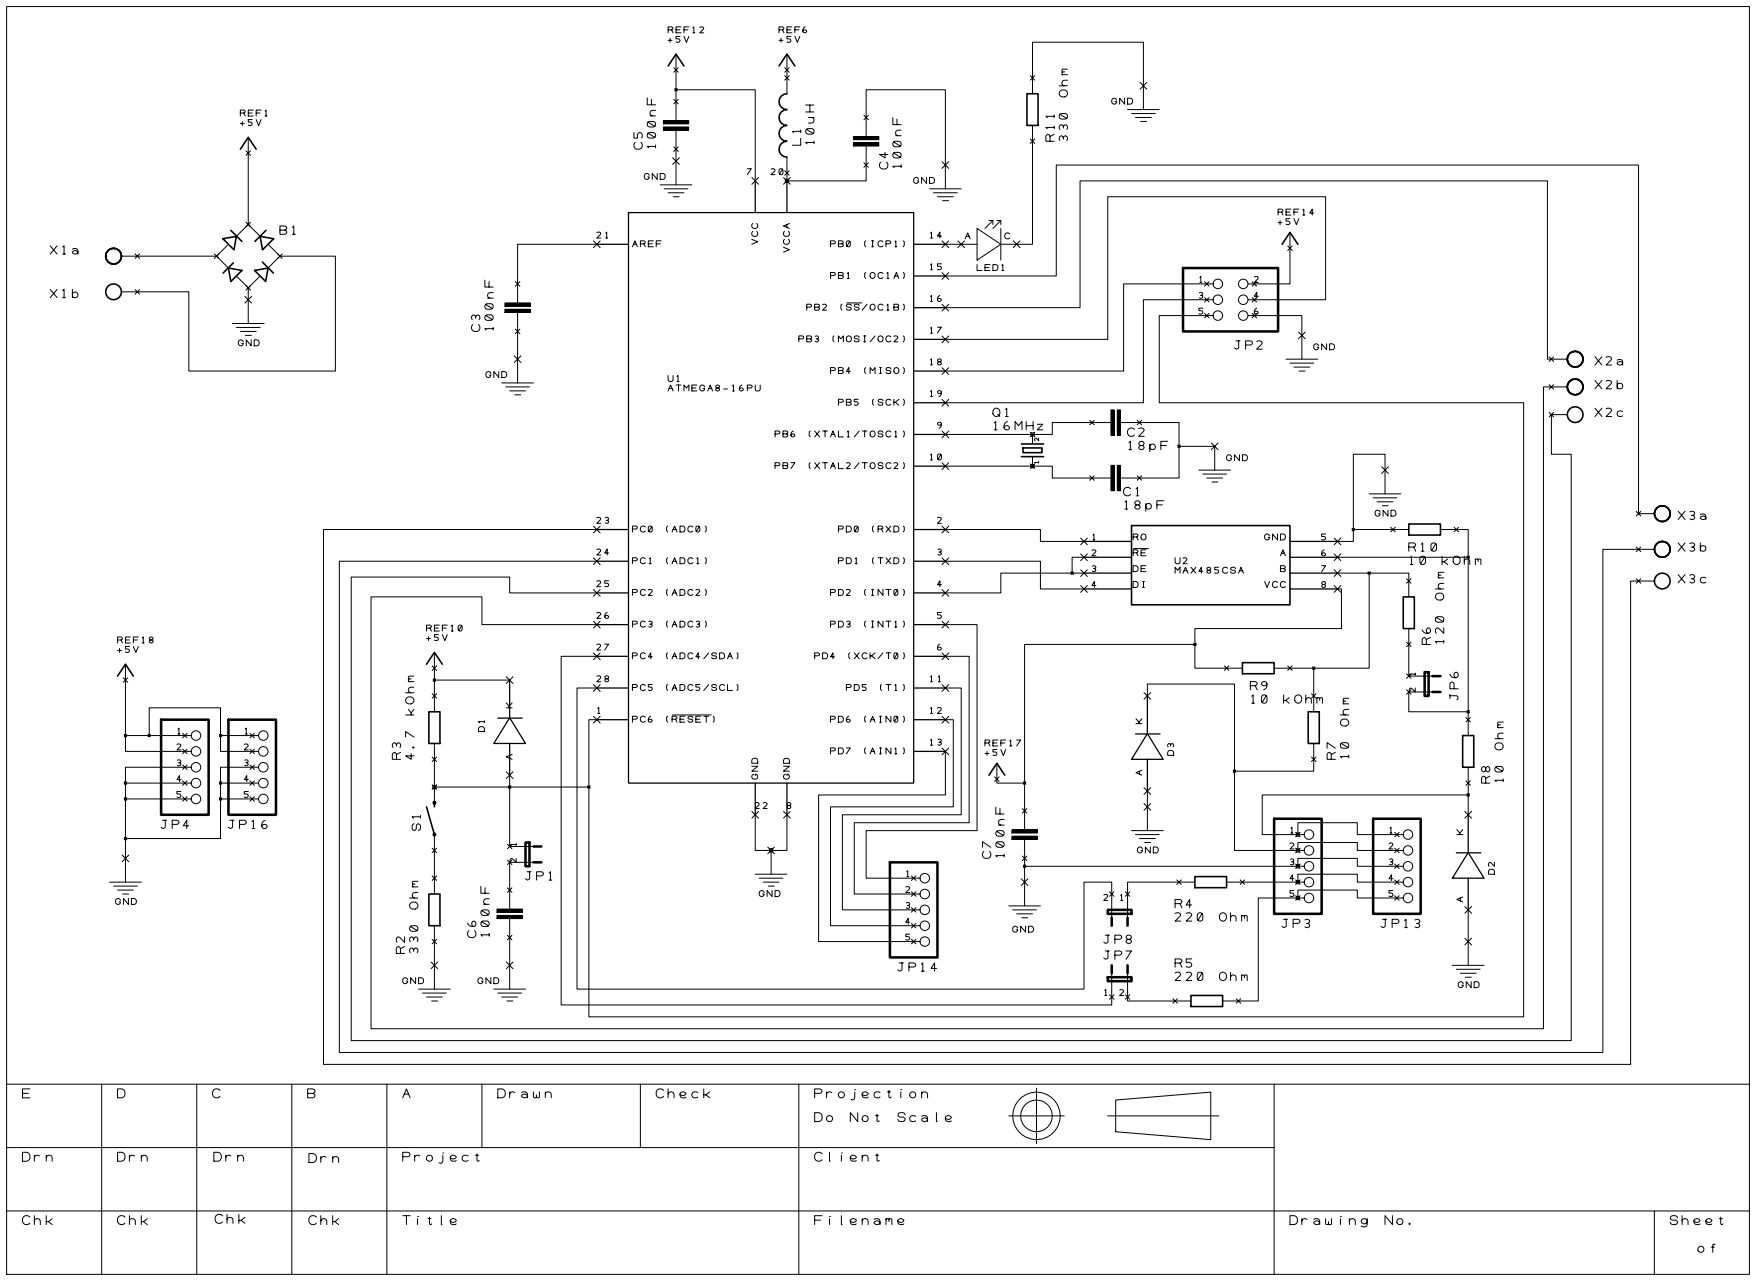
[picture p139: page 1]
