ziolman/robothand1234/projects/stepper_motor_translator_driver/stepper_motor_translator_driver - PCB.pdf

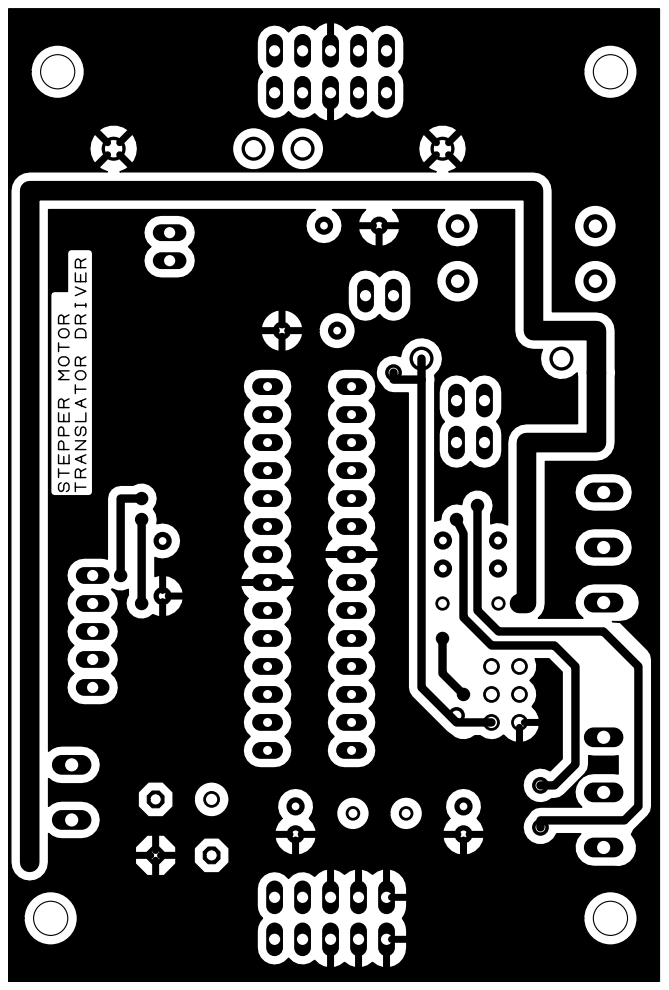
[picture p140: page 1]
