ziolman/robothand1234/projects/stepper_motor_translator_driver/stepper_motor_translator_driver - Project.pdf

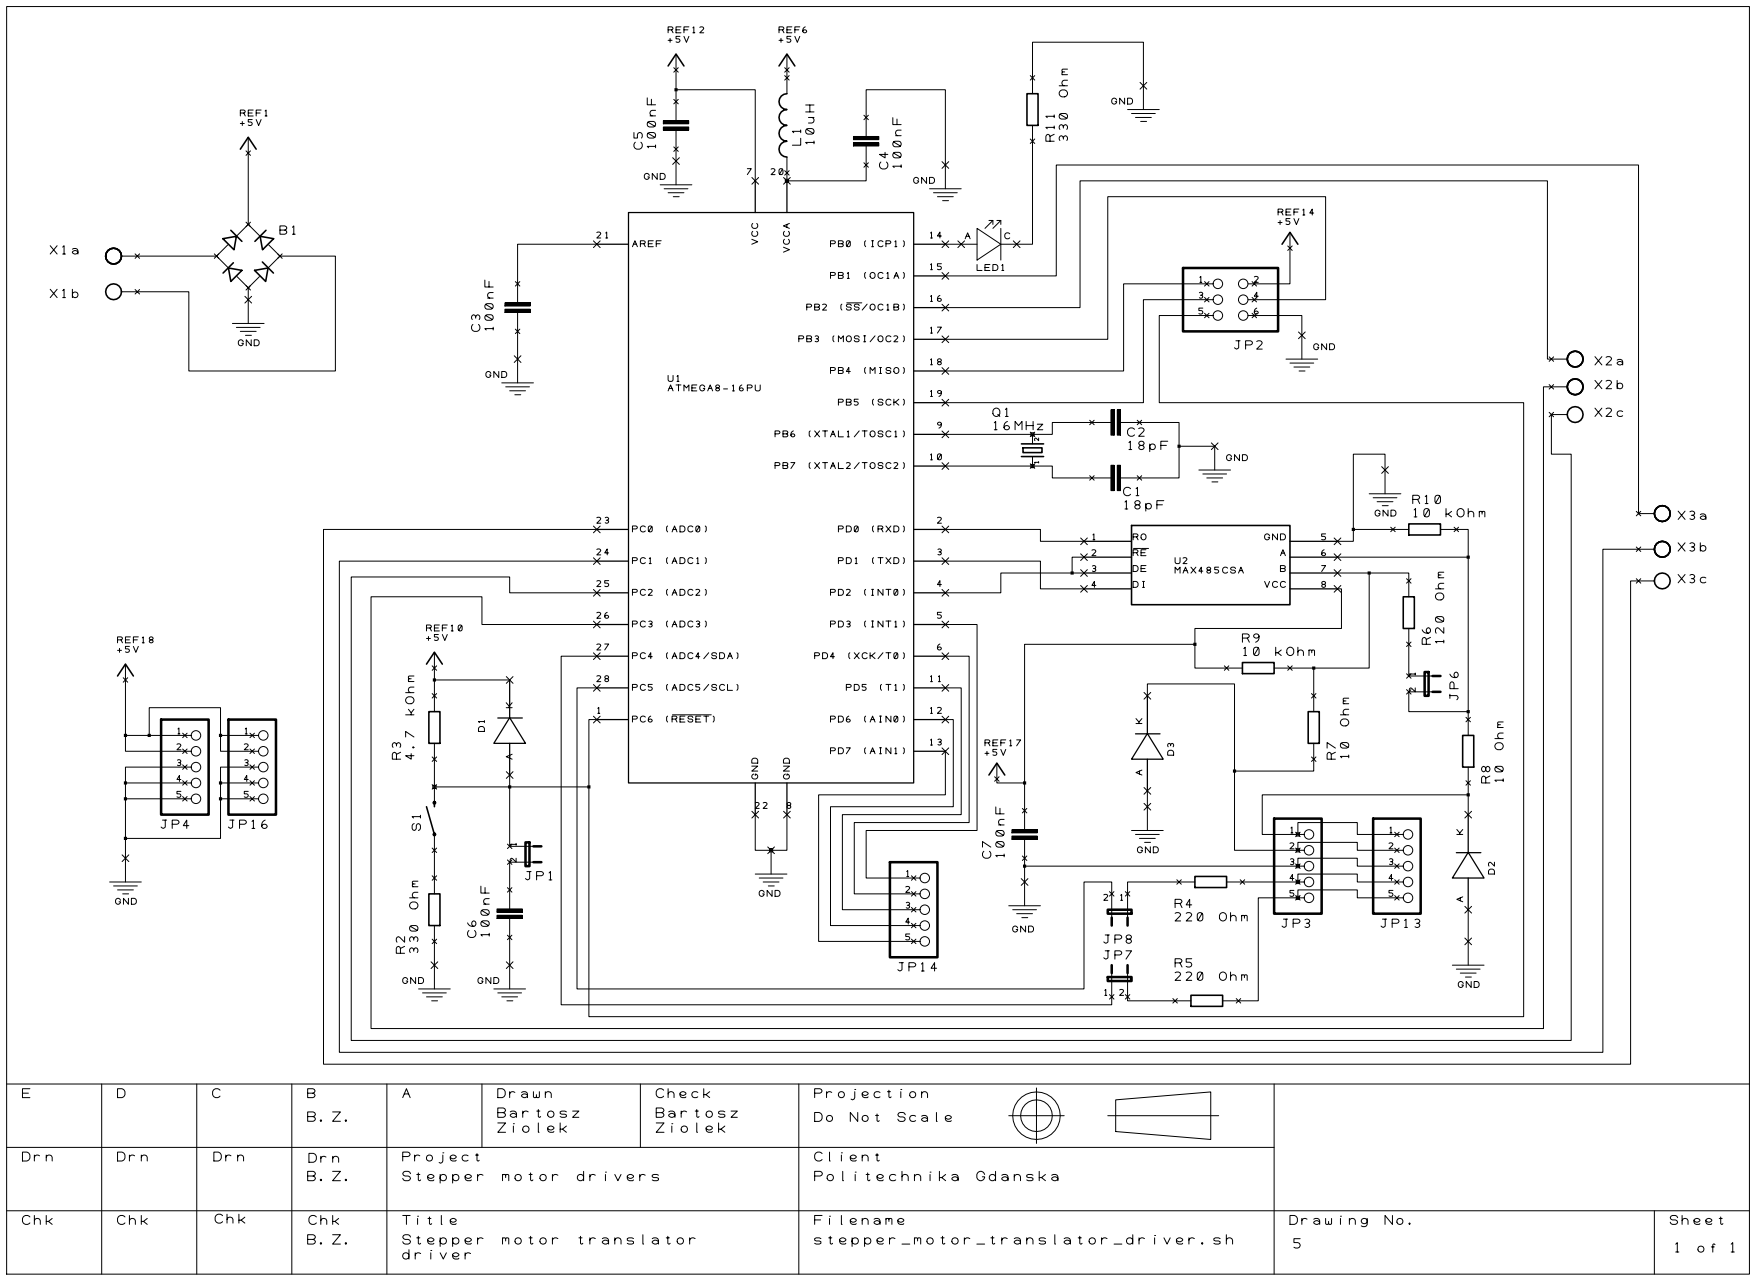
[picture p141: page 1]
