ziolman/robothand1234/projects/A3977_stepper_driver_second/A3977_stepper_driver - PCB.pdf

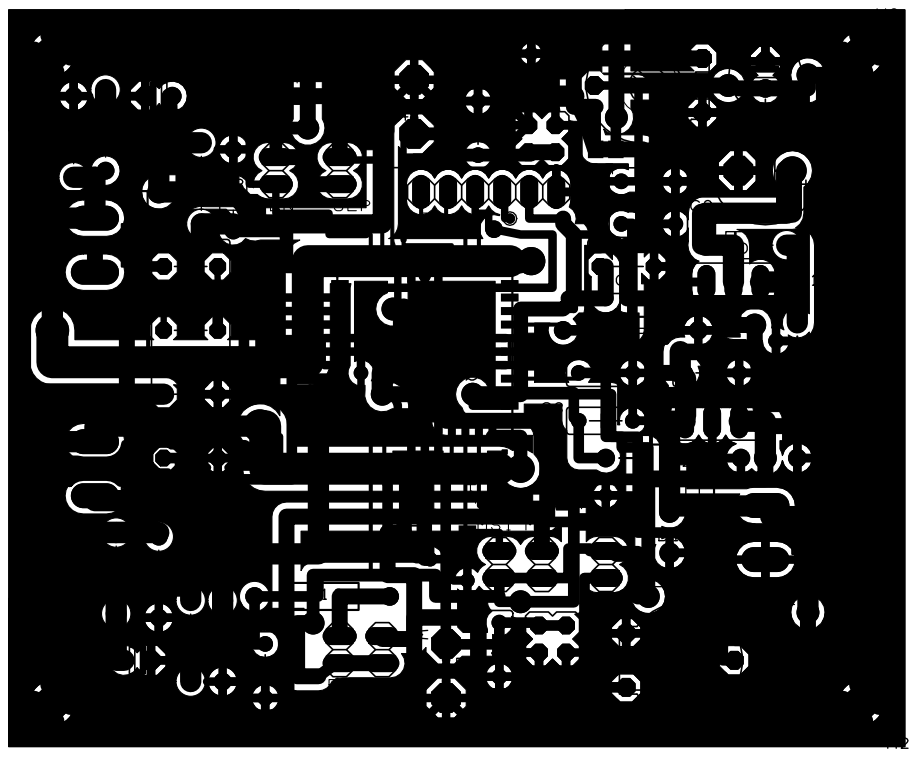
[picture p142: page 1]
