ziolman/robothand1234/projects/A3977_stepper_driver_second/A3977_stepper_driver - Project.pdf

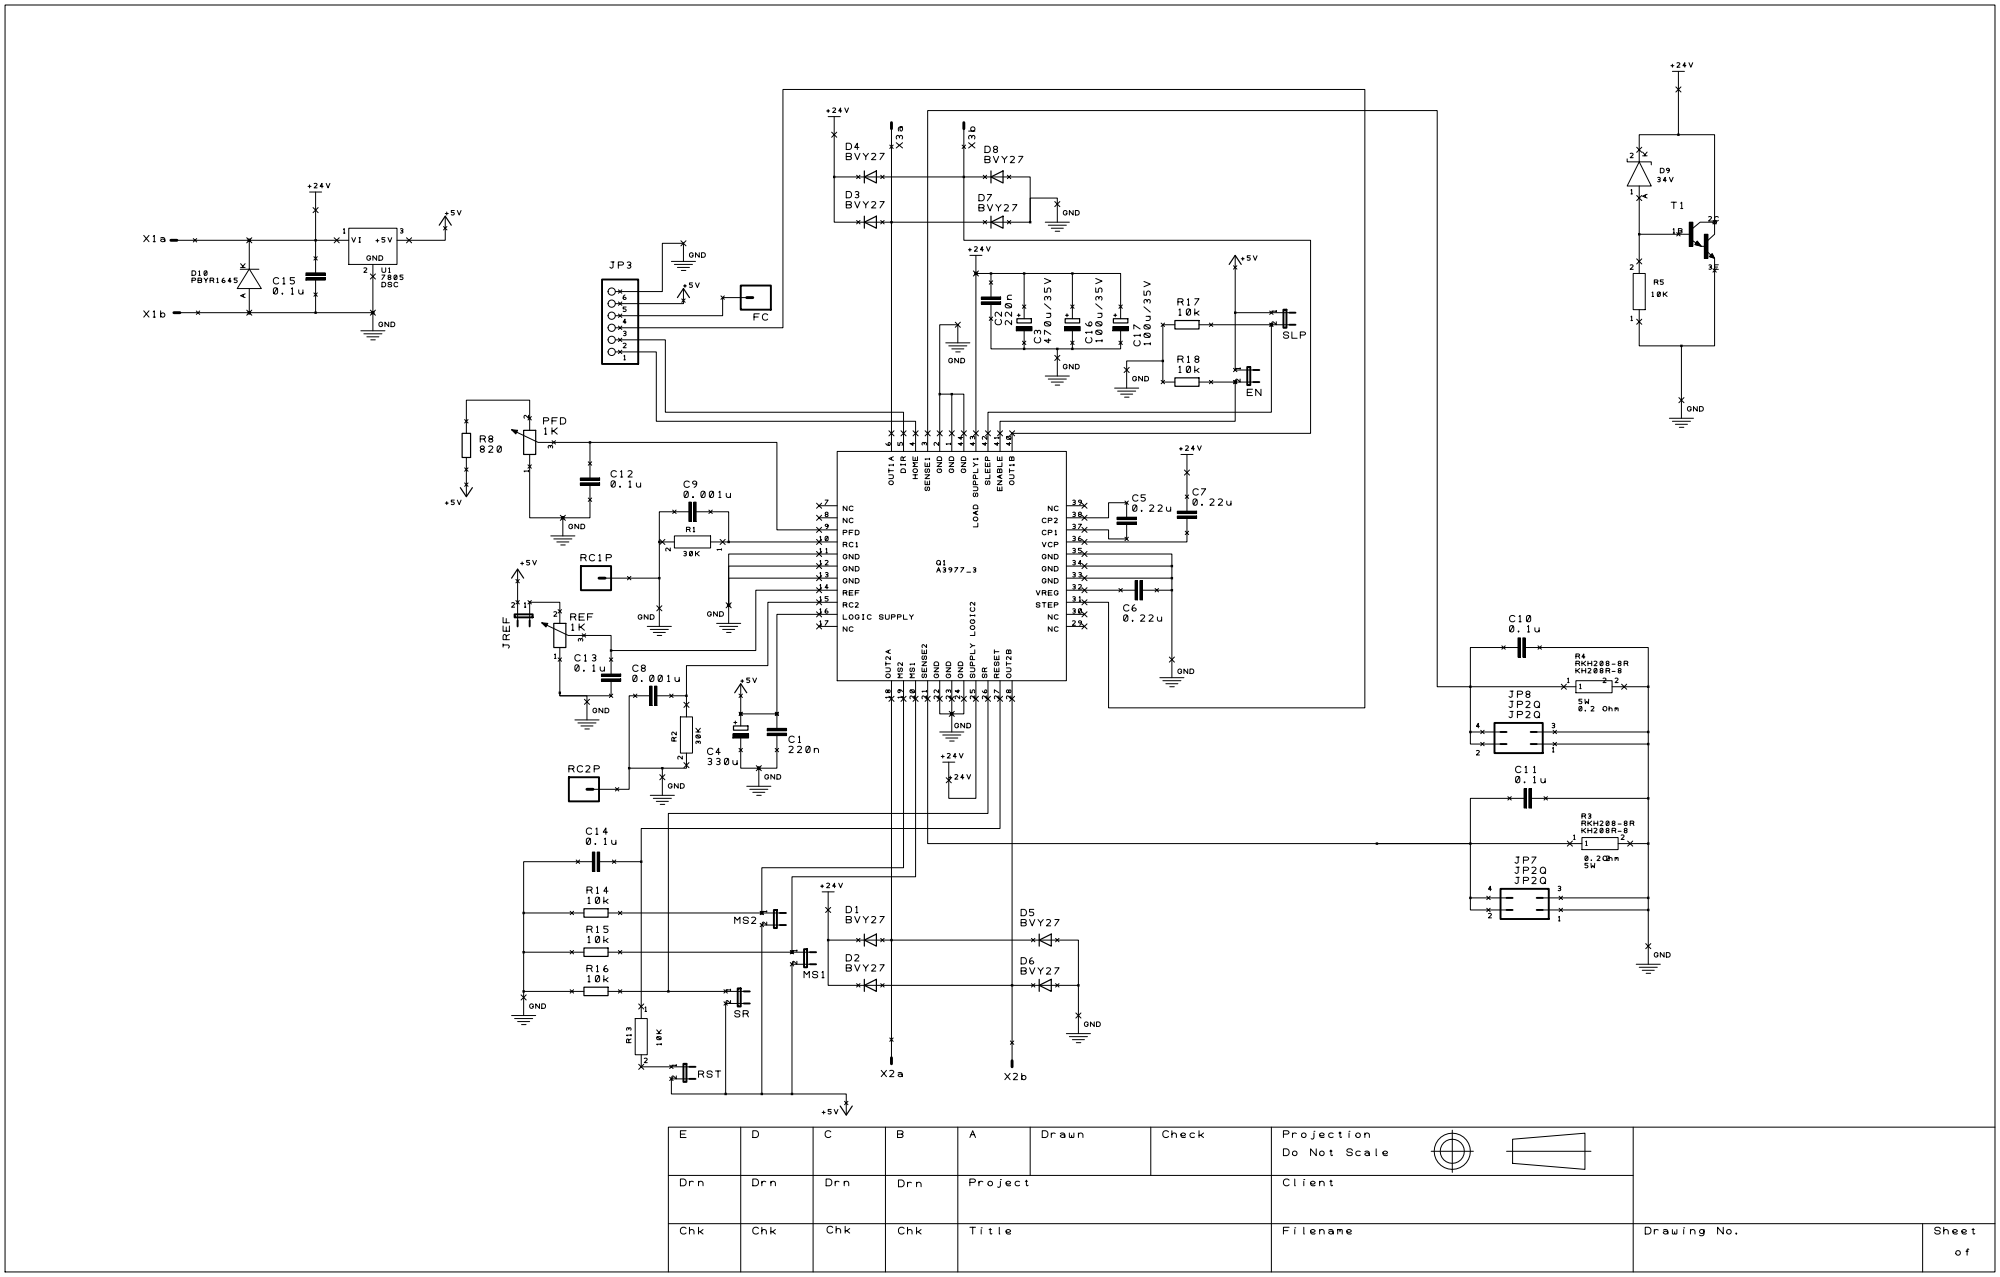
[picture p143: page 1]
