ziolman/robothand1234/(list of files, drawings)

Other design files:
projects/A3977_stepper_driver_second/A3977_stepper_driver.pcb
projects/A3977_stepper_driver_second/~A3977_stepper_driver.pcb
projects/differential_amplifiers_sensors/differential_amplifiers_sensors.pcb
projects/differential_amplifiers_sensors/~differential_amplifiers_sensors.pcb
projects/differential_amplifiers_sensors_multi/differential_amplifiers_sensors.pcb
projects/differential_amplifiers_sensors_multi/~differential_amplifiers_sensors.pcb
projects/fan controller/fan_controller.pcb
projects/fan controller/~fan_controller.pcb
projects/magnetic_sensors_circuit/magnetic_sensors_circuit.pcb
projects/magnetic_sensors_circuit/ss49_magnetic_sensor_circuit.pcb
projects/magnetic_sensors_circuit/~magnetic_sensors_circuit.pcb
projects/sensor_system_circuit/sensor_system_circuit.pcb
projects/sensor_system_circuit/~sensor_system_circuit.pcb
projects/ss49_magnetic_sensors_circuit/ss49_magnetic_sensor_circuit.pcb
projects/ss49_magnetic_sensors_circuit/ss49_magnetic_sensors_circuit.pcb
projects/ss49_magnetic_sensors_circuit/~ss49_magnetic_sensors_circuit.pcb
projects/stepper_motor_translator_driver/stepper_motor_translator_driver.pcb
projects/stepper_motor_translator_driver/~stepper_motor_translator_driver.pcb
projects/uart_rs485/uart_rs485.pcb
projects/uart_rs485/~uart_rs485.pcb
