ziolman/robothand1234/(commit log)

2012-12-08 First milestone
    First milestone
    [A3977_stepper_driver (Bill Of Materials).csv, A3977_stepper_driver.pcb, A3977_stepper_driver.sch, stepper_motor_translator_driver.pcb, stepper_motor_translator_driver.sch, teros_a3977.brd, teros_a3977.sch, ~A3977_stepper_driver.pcb]
2012-12-16 added magnetic sensors circuits pcb, schematics
    [A3977_stepper_driver (Bill Of Materials).csv, A3977_stepper_driver.pcb, A3977_stepper_driver.sch, differential_amplifiers_sensors.pcb, differential_amplifiers_sensors.sch, fan_controller.pcb, fan_controller.sch, magnetic_sensors_circuit.pcb]
2012-12-28 working on the second chapter
    [A3977_stepper_driver.pcb, A3977_stepper_driver.sch, differential_amplifiers_sensors.pcb, differential_amplifiers_sensors.sch, fan_controller.pcb, fan_controller.sch, magnetic_sensors_circuit.pcb, magnetic_sensors_circuit.sch]
